raphaelchang/quadthingy-hardware/pcb/Quadrotor/Project Outputs for Quadrotor/Quadrotor.xls

Comment | Description | Designator | Footprint | LibRef | Quantity
4.7uF | CAP 4.7uF 6.3V ±10% 0402 (1005 Metric) Thickness 0.6mm SMD | C1, C6, C21, C22, C23, C24, C25, C26, C28, C29, C31, C32 | CAPC0402(1005)60_L | CMP-1034-02136-1 | 12.0
15pF | CAP 15pF 25V ±0.25pF 0402 (1005 Metric) Thickness 0.6mm SMD | C2, C3 | CAPC0402(1005)60_M | CMP-1034-00804-1 | 2.0
22pF | CAP 22pF 25V ±10% 0402 (1005 Metric) Thickness 0.6mm SMD | C4, C5 | CAPC0402(1005)60_L | CMP-1034-00911-1 | 2.0
100nF | CAP 100nF 6.3V ±5% 0402 (1005 Metric) Thickness 0.6mm SMD | C7, C10, C14 | CAPC0402(1005)60_M | CMP-1034-02060-1 | 3.0
120nF | CAP 100nF 6.3V ±5% 0402 (1005 Metric) Thickness 0.6mm SMD | C8 | CAPC0402(1005)60_M | CMP-1034-02060-1 | 1.0
6.8nF | CAP 6.8nF 6.3V ±5% 0402 (1005 Metric) Thickness 0.6mm SMD | C9 | CAPC0402(1005)60_L | CMP-1034-01836-1 | 1.0
33nF | CAP 33nF 6.3V ±10% 0402 (1005 Metric) Thickness 0.6mm SMD | C11 | CAPC0402(1005)60_M | CMP-1034-01977-1 | 1.0
10nF | CAP 10nF 6.3V ±5% 0402 (1005 Metric) Thickness 0.6mm SMD | C12 | CAPC0402(1005)60_M | CMP-1034-01867-1 | 1.0
1nF | CAP 1nF 6.3V ±5% 0402 (1005 Metric) Thickness 0.6mm SMD | C13 | CAPC0402(1005)60_M | CMP-1034-01609-1 | 1.0
1.5pF | CAP 1.5pF 25V ±0.5pF 0402 (1005 Metric) Thickness 0.6mm SMD | C15 | CAPC0402(1005)60_L | CMP-1034-00110-1 | 1.0
1pF | CAP 1pF 25V ±0.5pF 0402 (1005 Metric) Thickness 0.6mm SMD | C16 | CAPC0402(1005)60_M | CMP-1034-00055-1 | 1.0
2.2nF | CAP 2.2nF 6.3V ±5% 0402 (1005 Metric) Thickness 0.6mm SMD | C17 | CAPC0402(1005)60_N | CMP-1034-01722-1 | 1.0
4.7pF | CAP 4.7pF 25V ±0.1pF 0402 (1005 Metric) Thickness 0.6mm SMD | C18 | CAPC0402(1005)60_M | CMP-1034-00362-1 | 1.0
15pF | CAP 15pF 25V ±10% 0402 (1005 Metric) Thickness 0.6mm SMD | C19, C20 | CAPC0402(1005)60_N | CMP-1034-00809-1 | 2.0
2.2uF | CAP 2.2uF 6.3V ±10% 0402 (1005 Metric) Thickness 0.6mm SMD | C27 | CAPC0402(1005)60_M | CMP-1034-02125-1 | 1.0
10uF | CAP 10uF 6.3V ±20% 0402 (1005 Metric) Thickness 0.6mm SMD | C30 | CAPC0402(1005)60_N | CMP-1034-02138-1 | 1.0
0.1uF | CAP 100nF 6.3V ±5% 0402 (1005 Metric) Thickness 0.6mm SMD | C33 | CAPC0402(1005)60_M | CMP-1034-02060-1 | 1.0
LED-BLUE |  | D1 | LED-1206 | LED-BLUE1206 | 1.0
WS2812B |  | D2, D4, D5, D6 | WS2812B | WS2812B | 4.0
LED-GREEN |  | D3 | LED-1206 | LED-GREEN1206 | 1.0
MBRA210LT3G | Schottky Power Rectifier, 2-Pin SMA, Pb-Free, Tape and Reel | D7 | ONSC-SMA-2-403D-02_F_V | CMP-1055-00309-1 | 1.0
 |  | JP1, JP2 | JST-2-PTH-VERT | JST_2_RIGHT | 2.0
USB |  | JP3 | USB-MICROB | USB_MICROB_PLUG-SMT | 1.0
3.9nH | Inductor | L1 | INDC0402(1005)_N | INDC0402 | 1.0
8.2nH | Inductor | L2 | INDC0402(1005)_N | INDC0402 | 1.0
2.7nH | Inductor | L3 | INDC0402(1005)_N | INDC0402 | 1.0
MOSFET-P | P-Channel MOSFET | Q1 | SOT23-3 | MOSFET-P | 1.0
22R | 22R 0.063W 5% 0402 (1005 Metric) SMD | R1, R2 | RESC0402(1005)_M | CMP-1011-00034-1 | 2.0
10K | 10K 0.063W 5% 0402 (1005 Metric) SMD | R3, R4, R5, R6, R7, R8, R9, R10, R11, R19 | RESC0402(1005)_N | CMP-1011-00098-1 | 10.0
22K | 22K 0.063W 5% 0402 (1005 Metric) SMD | R12 | RESC0402(1005)_L | CMP-1011-00106-1 | 1.0
10R | 10R 0.063W 5% 0402 (1005 Metric) SMD | R13 | RESC0402(1005)_N | CMP-1011-00026-1 | 1.0
0.006R | Jumper 0805 (2012 Metric) | R14 | RESC0805(2012)_N | CMP-1013-00001-1 | 1.0
91R | 91R 0.063W 5% 0402 (1005 Metric) SMD | R15 | RESC0402(1005)_M | CMP-1011-00049-1 | 1.0
0.1R | 1R 0.1W 5% 0603 (1608 Metric) SMD | R16 | RESC0603(1608)_M | CMP-1012-00002-1 | 1.0
19K6 | 20K 0.063W 5% 0402 (1005 Metric) SMD | R17 | RESC0402(1005)_M | CMP-1011-00105-1 | 1.0
5K1 | 5K1 0.063W 5% 0402 (1005 Metric) SMD | R18 | RESC0402(1005)_L | CMP-1011-00091-1 | 1.0
 | Switch, SPNO Push Button SMD | SW1, SW2 | SWITCH | DIPT-DTSM-6 | 2.0
STMF446 |  | U1 | STM-LQFP64_N | MC-ARM-STM32F4X5-SQ64 | 1.0
MS5611 |  | U2 | MS5611 | MS5611 | 1.0
BNO055 |  | U3 | LGA28R50P4X10_380X520X100 | BNO055 | 1.0
 |  | U4 | QFN20 | NRF24L01+ | 1.0
ADM7171 |  | U5 | SON50P300X85_HS-9N | ADM7171 | 1.0
MCP8063 | 3-Phase Brushless DC Sinusoidal Sensorless Fan Motor Driver, MOSFET Output, 2 to 14 V, 8-pin SOP (SE8), Tube | U6, U7, U9, U11 | DFN8 | MCP8063 | 4.0
MAX4173 | Voltage-Output, High-Side Current-Sense Amplifier, 50 V / V Gain, -40 to 85 degC, 6-Pin SOT23 (U6+1), Pb-Free, Tape and Reel | U8 | MAXM-U6+1_M | CMP-0252-00331-1 | 1.0
LTC1731 | Linear Charger with AC Adapter Detection, 4.5 to 12 V Vin, 8-pin SOP (MS8-8), -40 to 85 degC, Pb-Free, Tape and Reel | U10 | LT-MS8-8_L | CMP-0471-00369-1 | 1.0
 |  | Y1, Y2 | ABRA-ABM3B-4_V | ABRA-ABM3B-4 | 2.0
ABS07 |  | Y3 | ABS07 | ABS07 | 1.0
