raphaelchang/quadthingy-hardware/cad/MotorMount_Alt.SLDPRT

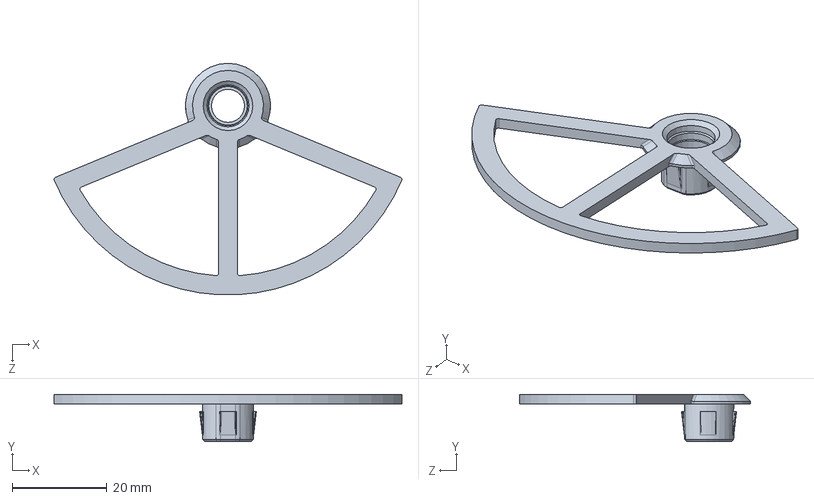
[picture p1: CAD file, 2020-12-25]
cad/MotorMount_Alt.SLDPRT
73.6 x 10.0 x 48.9 mm
