raphaelchang/quadthingy-hardware/pcb/outline.dxf

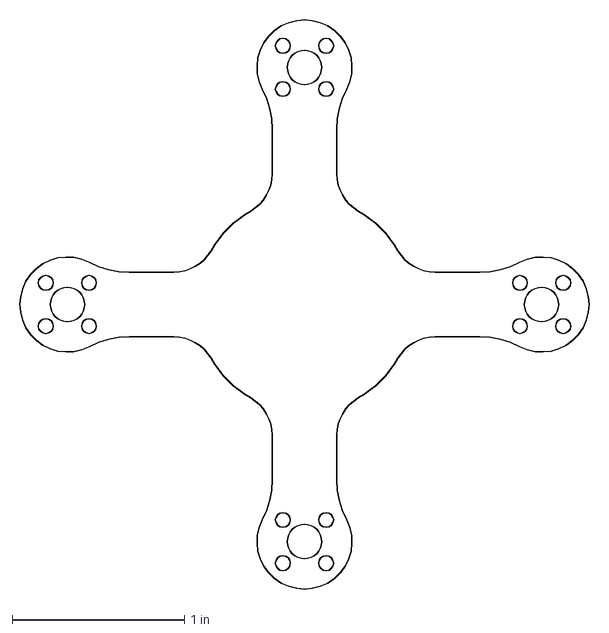
[picture p2: CAD file, 2016-02-01]
pcb/outline.dxf
3.34 x 3.34 in
