raphaelchang/quadthingy-hardware/pcb/Quadrotor/Outline.SLDPRT

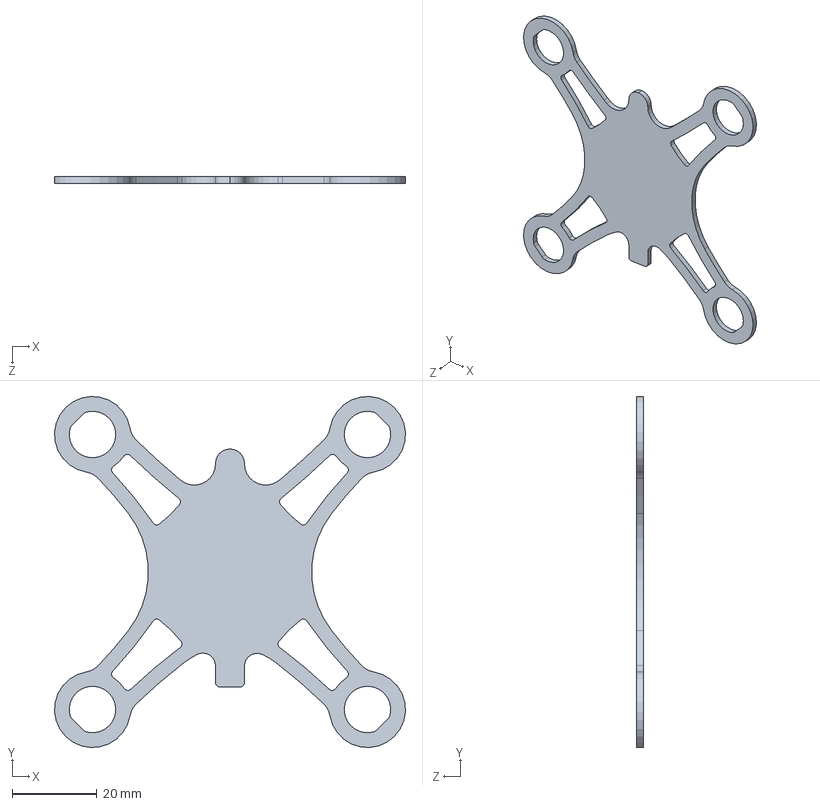
[picture p3: CAD file, 2016-12-26]
pcb/Quadrotor/Outline.SLDPRT
83.0 x 83.0 x 1.60 mm
