raphaelchang/quadthingy-hardware/cad/MotorMount.STEP

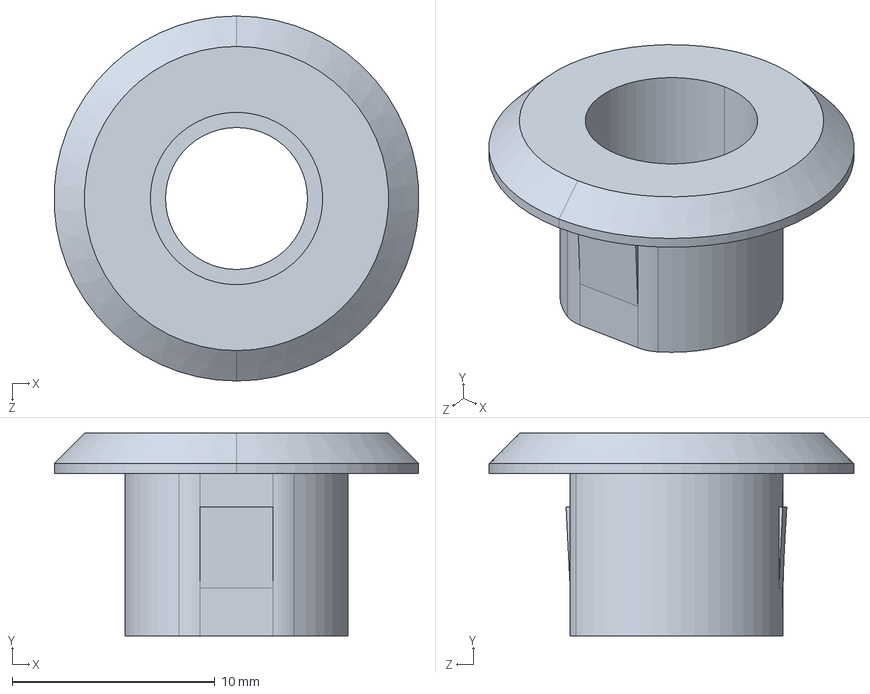
[picture p4: CAD file, 2020-12-25]
cad/MotorMount.STEP
18.0 x 10.0 x 18.0 mm
