raphaelchang/quadthingy-hardware/cad/BaseStationTop.SLDPRT

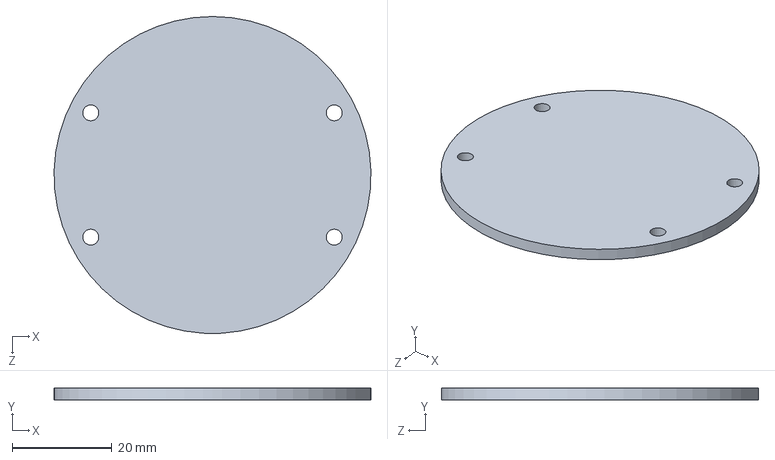
[picture p5: CAD file, 2020-12-25]
cad/BaseStationTop.SLDPRT
63.5 x 2.38 x 63.5 mm
