raphaelchang/quadthingy-hardware/cad/Motor.STEP

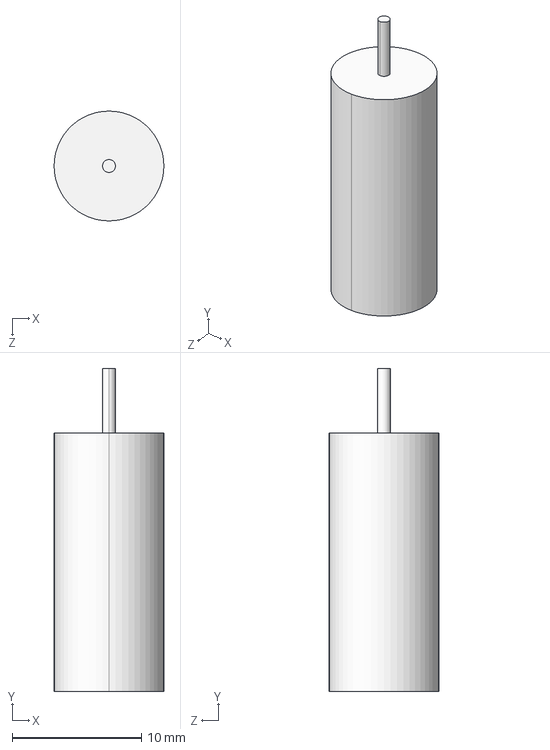
[picture p6: CAD file, 2016-12-26]
cad/Motor.STEP
8.50 x 25.0 x 8.50 mm
