raphaelchang/quadthingy-hardware/cad/MotorHolder.SLDPRT

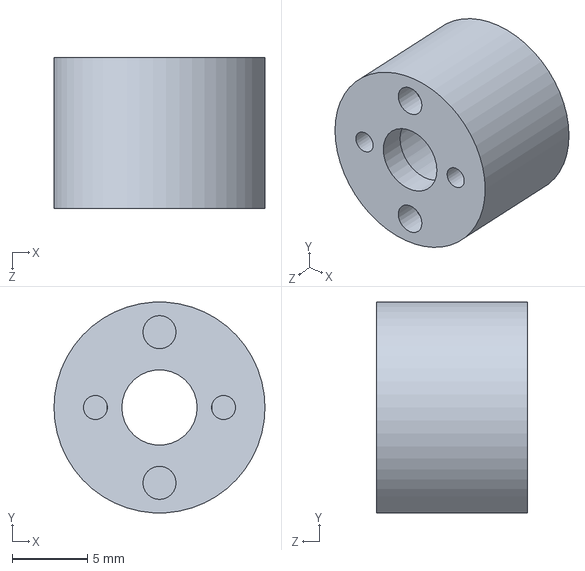
[picture p7: CAD file, 2016-05-14]
cad/MotorHolder.SLDPRT
14.0 x 14.0 x 10.0 mm
