raphaelchang/quadthingy-hardware/(list of files, cad)

Other CAD files:
cad/Motor.SLDPRT
pcb/OldVersions/V1.1/outline.ipt
pcb/OldVersions/V1/OldVersions/outline.0006.ipt
pcb/OldVersions/V1/OldVersions/outline.0008.ipt
pcb/OldVersions/V1/outline.ipt
pcb/Quadrotor/Outline.DXF
pcb/outline.ipt
