raphaelchang/quadthingy-hardware/pcb/Quadrotor/Quadrotor.pdf

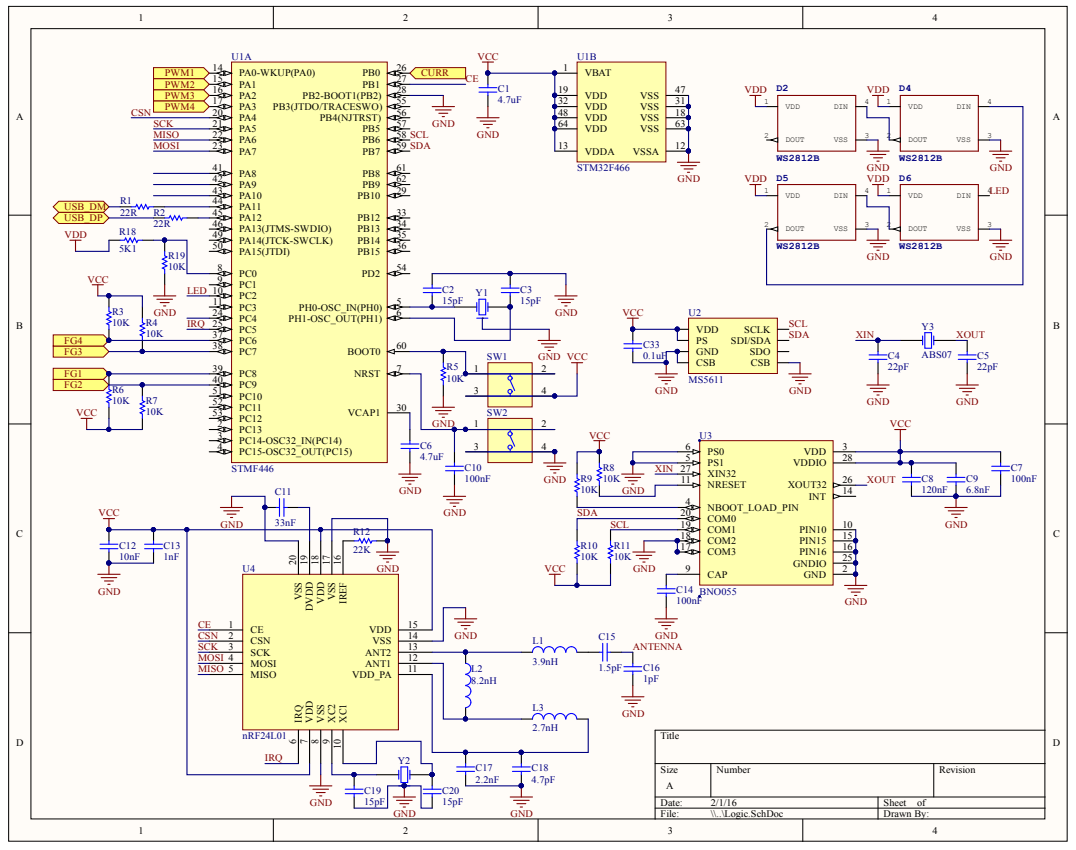
[picture p8: page 1]

CE 1 CSN 2 SCK 3 MOSI 4 MISO 5

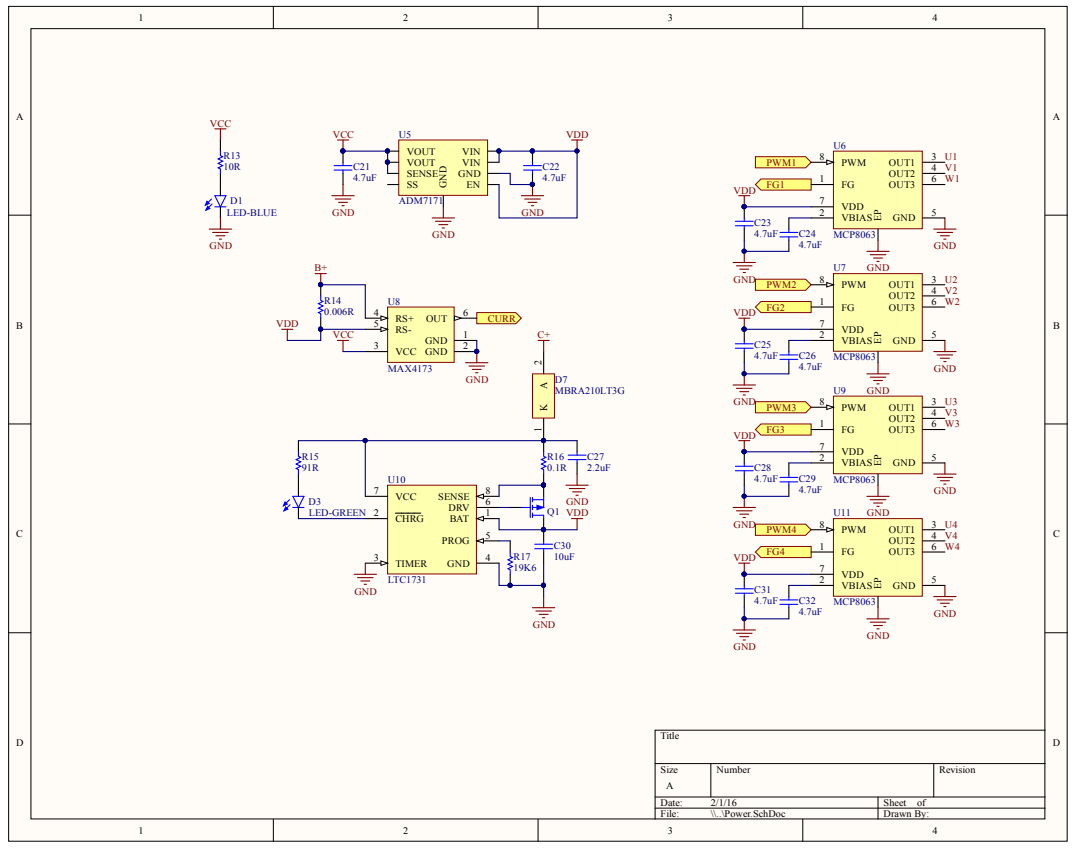
[picture p9: page 2]

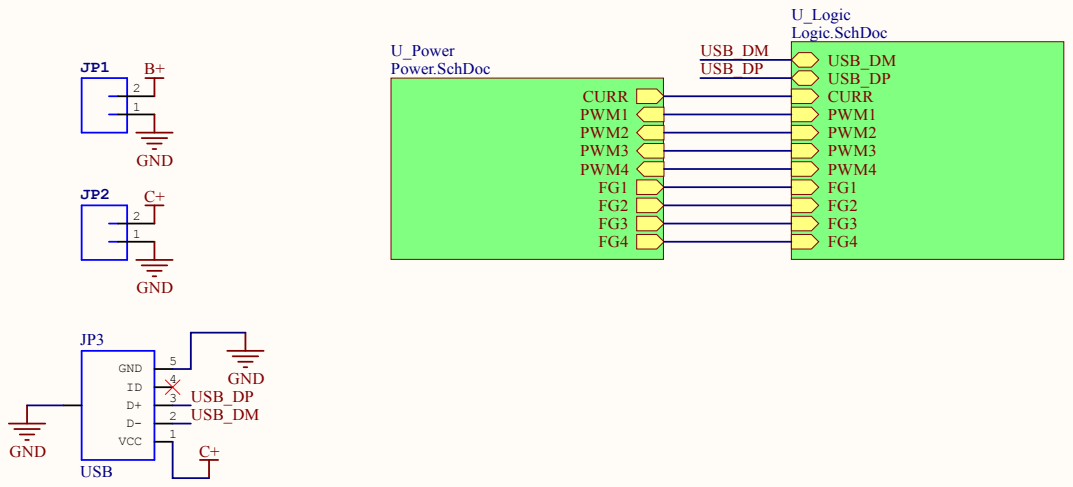
[picture p10: page 3]

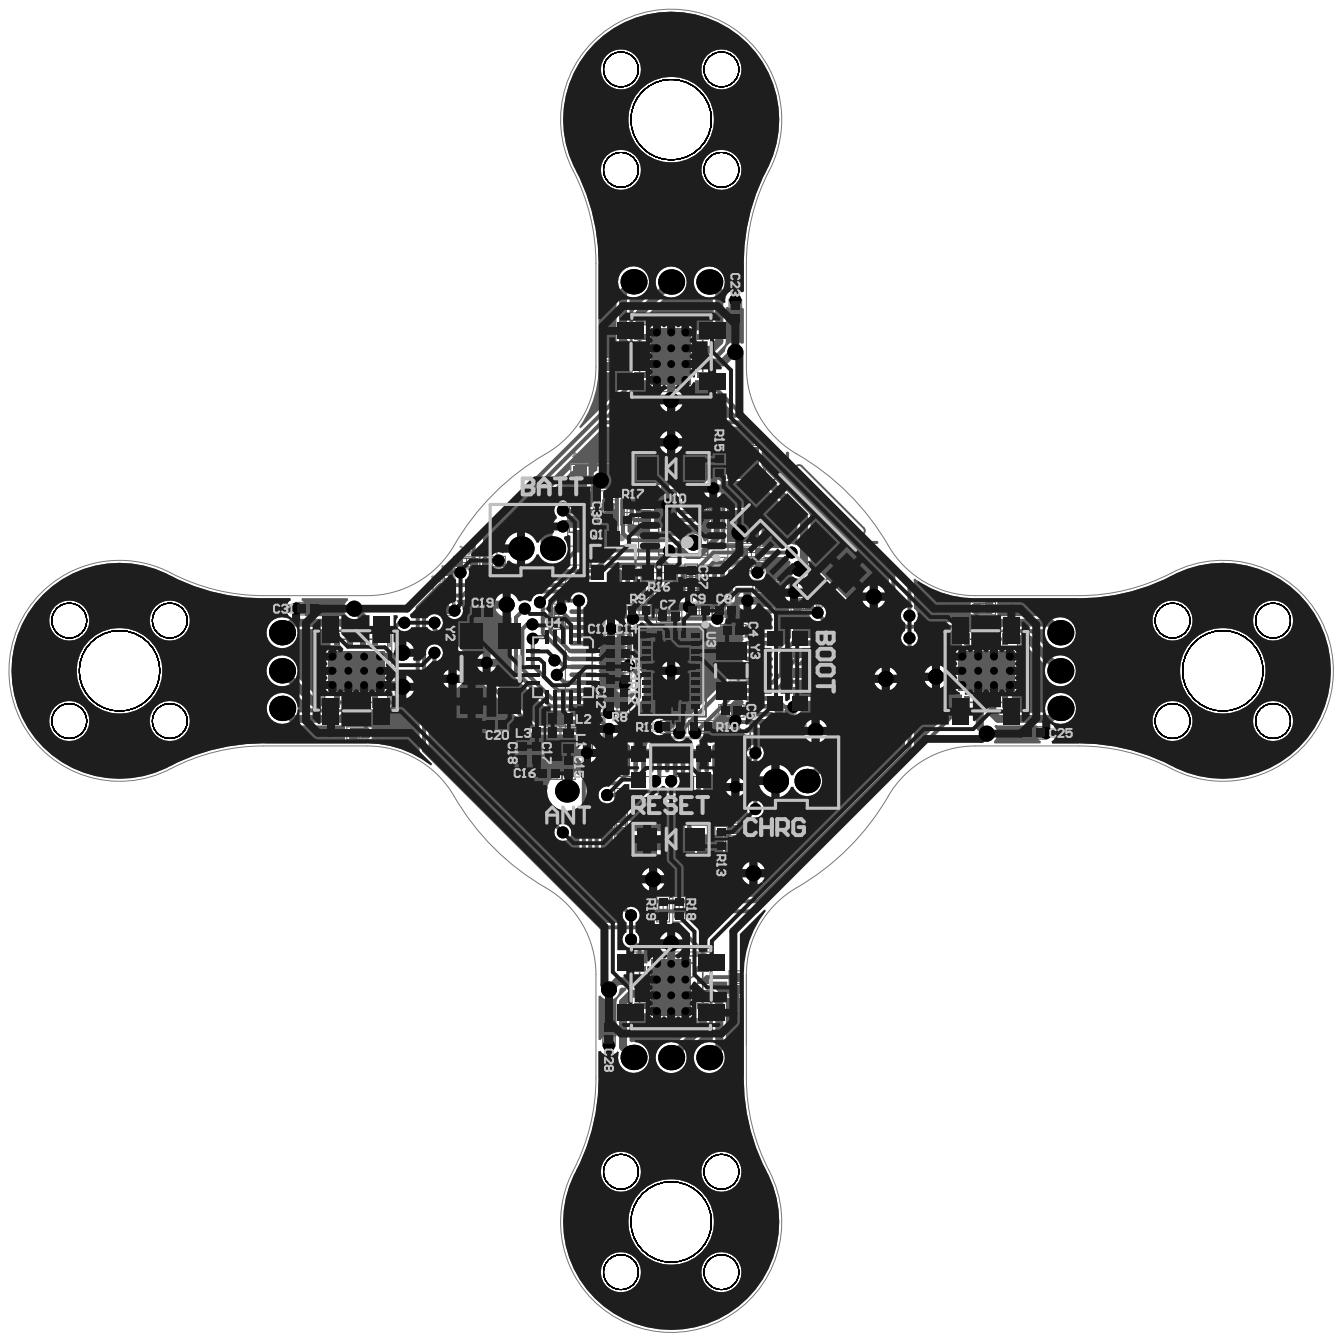
[picture p11: page 4]
