raphaelchang/quadthingy-hardware/pcb/BaseStation/Project Outputs for BaseStation/PDF/BaseStation.PDF

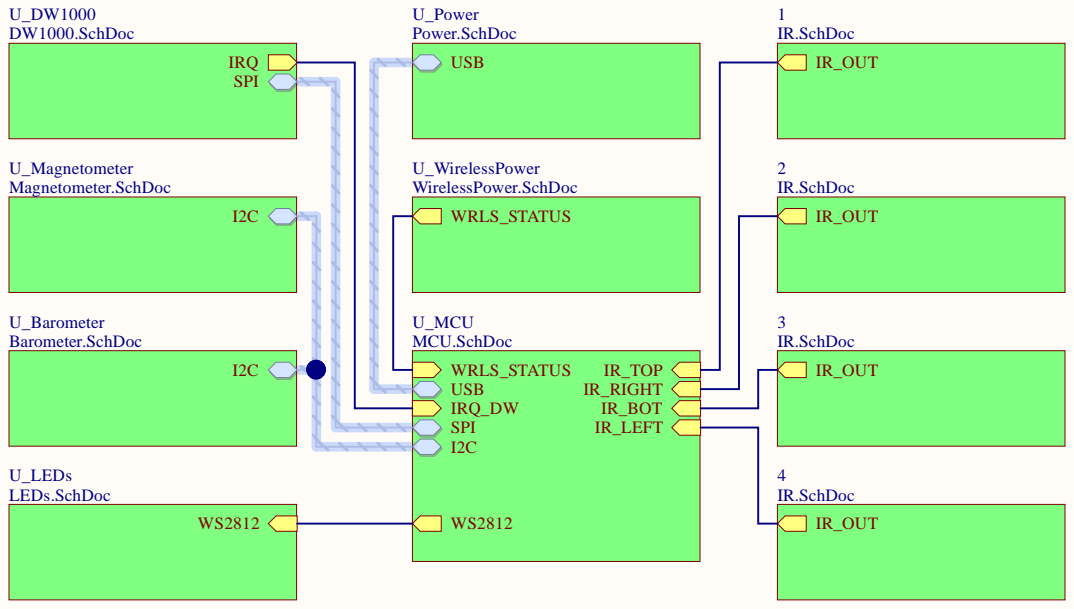
[picture p12: page 1]

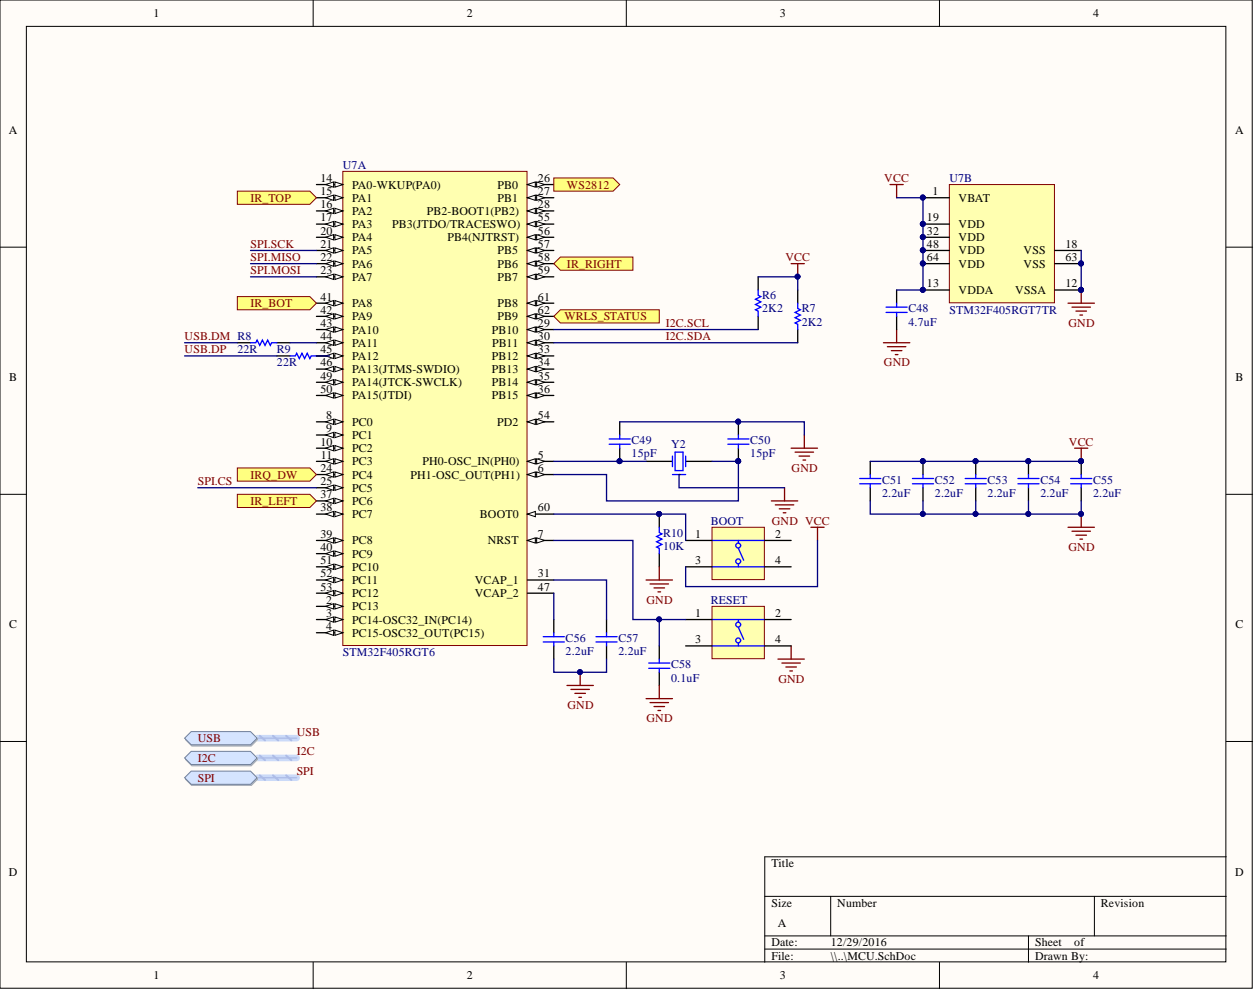
[picture p13: page 2]

PC8 39 | R10
PC9 40 | 10K | 3 | 4

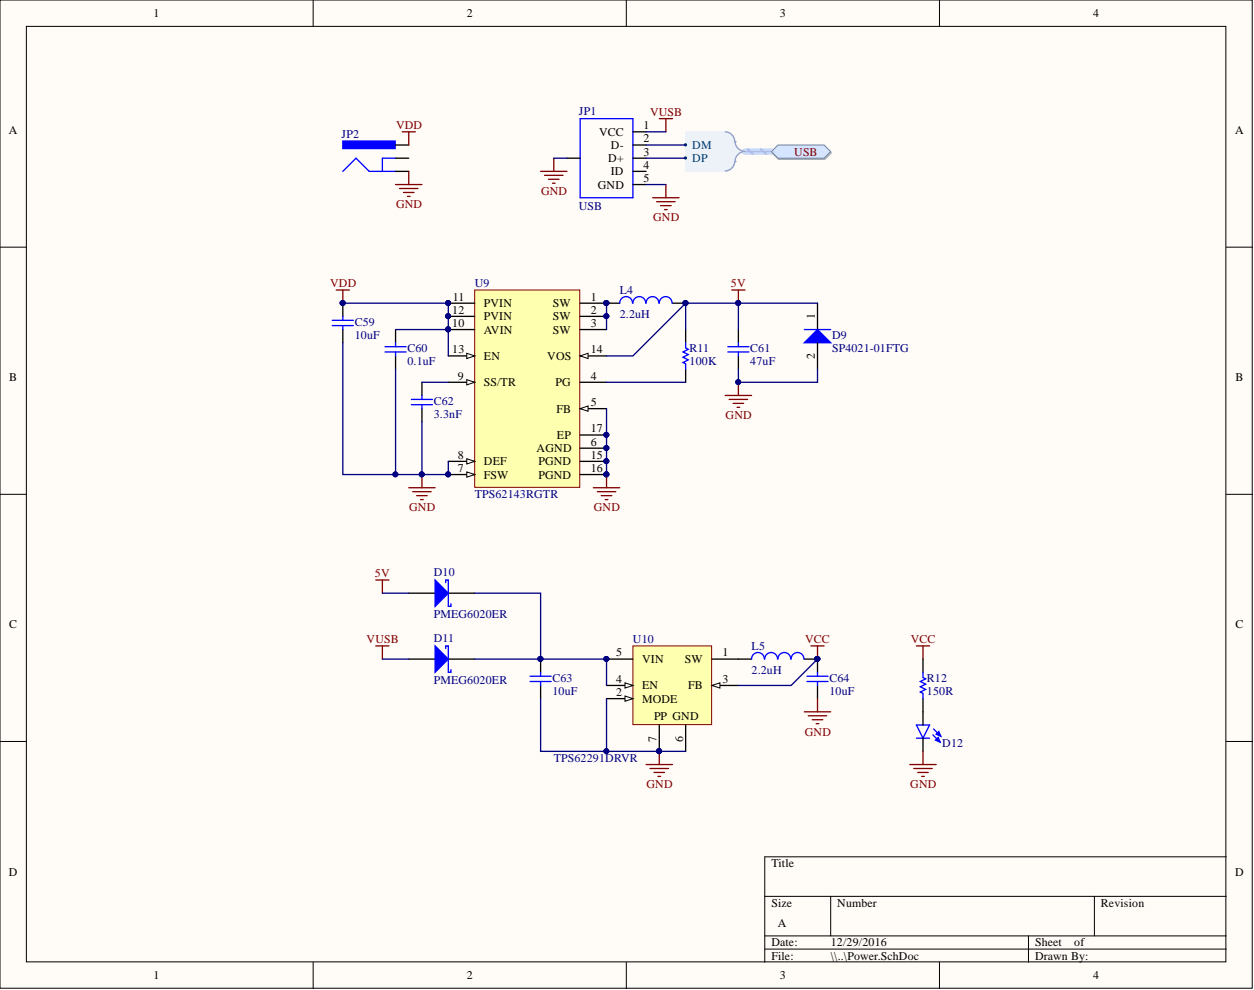
[picture p14: page 3]

C60
0.1uF | SS/TR 9

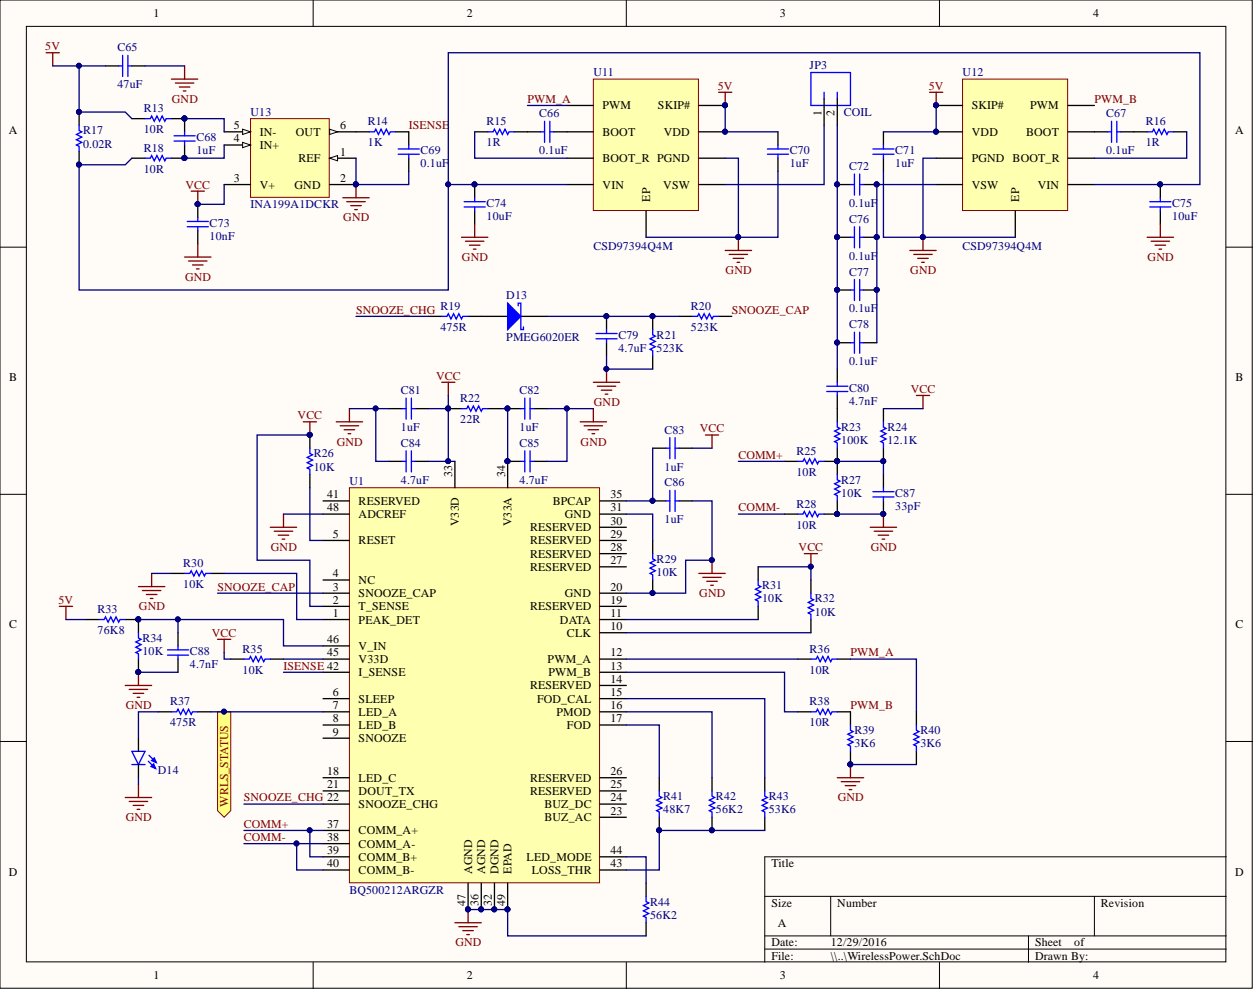
[picture p15: page 4]

R34 | VCC | V33D 45 V_IN 46

I_SENSE 42

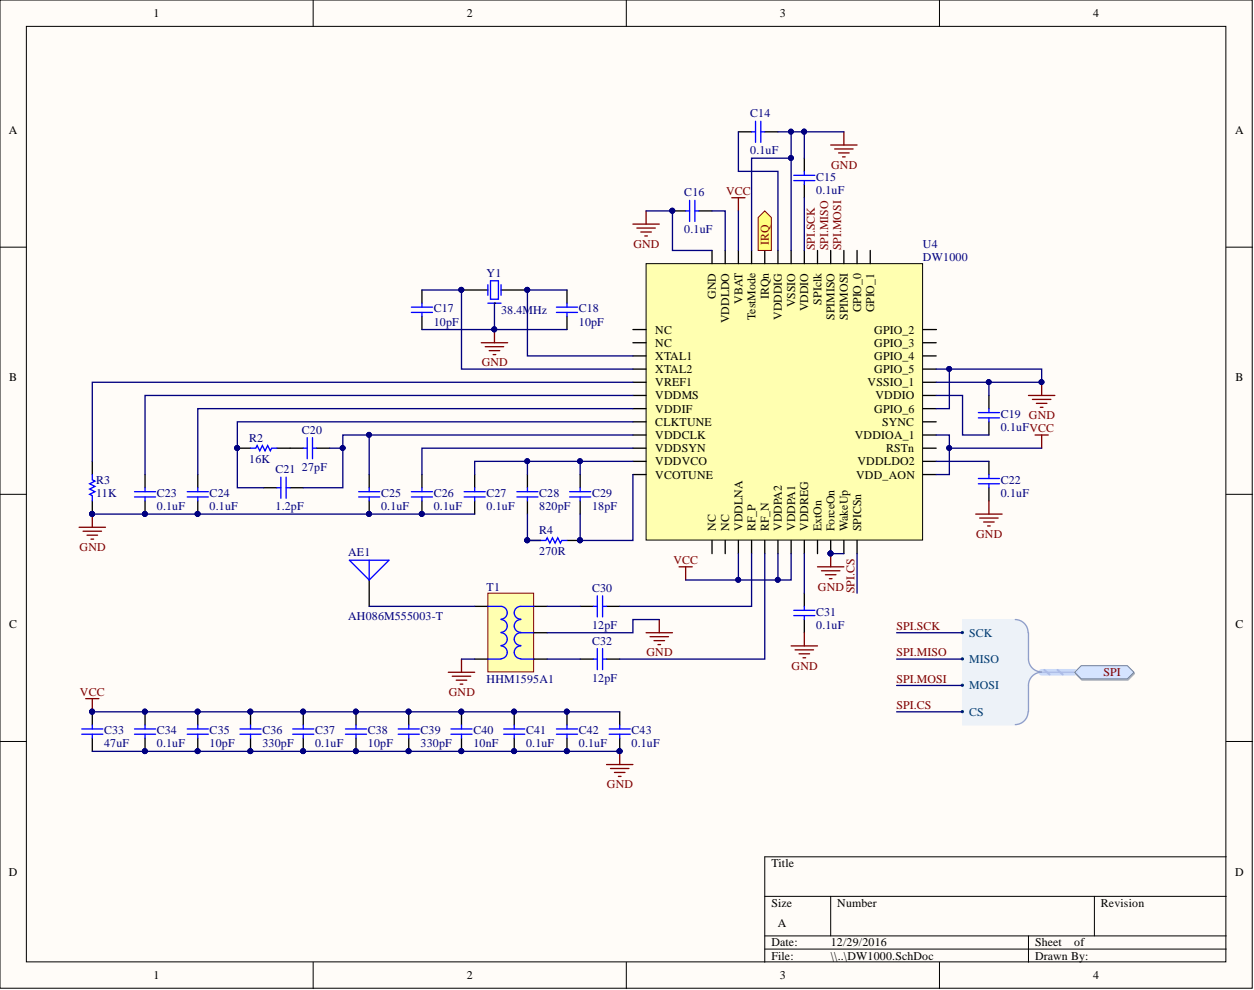
[picture p16: page 5]

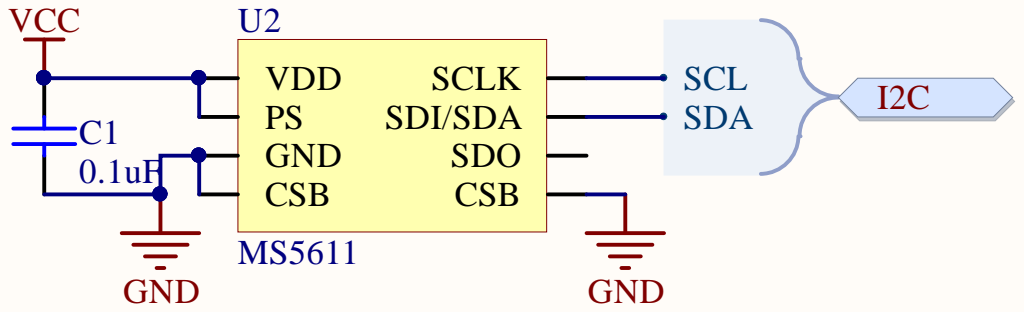
[picture p17: page 6]

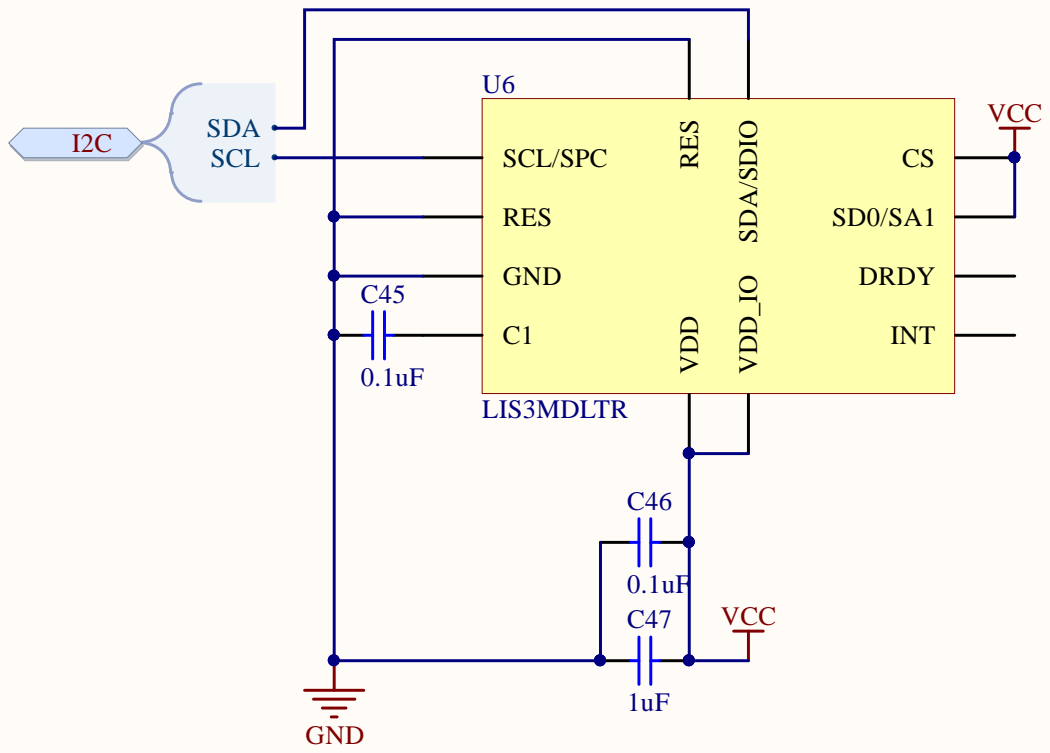
[picture p18: page 7]

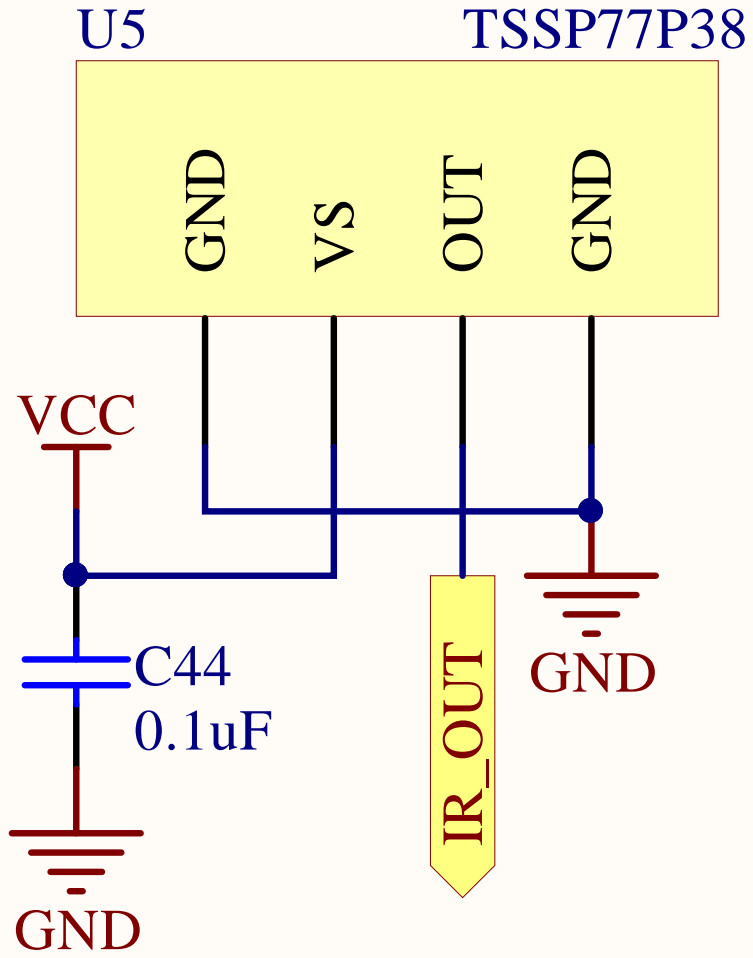
[picture p19: page 8]

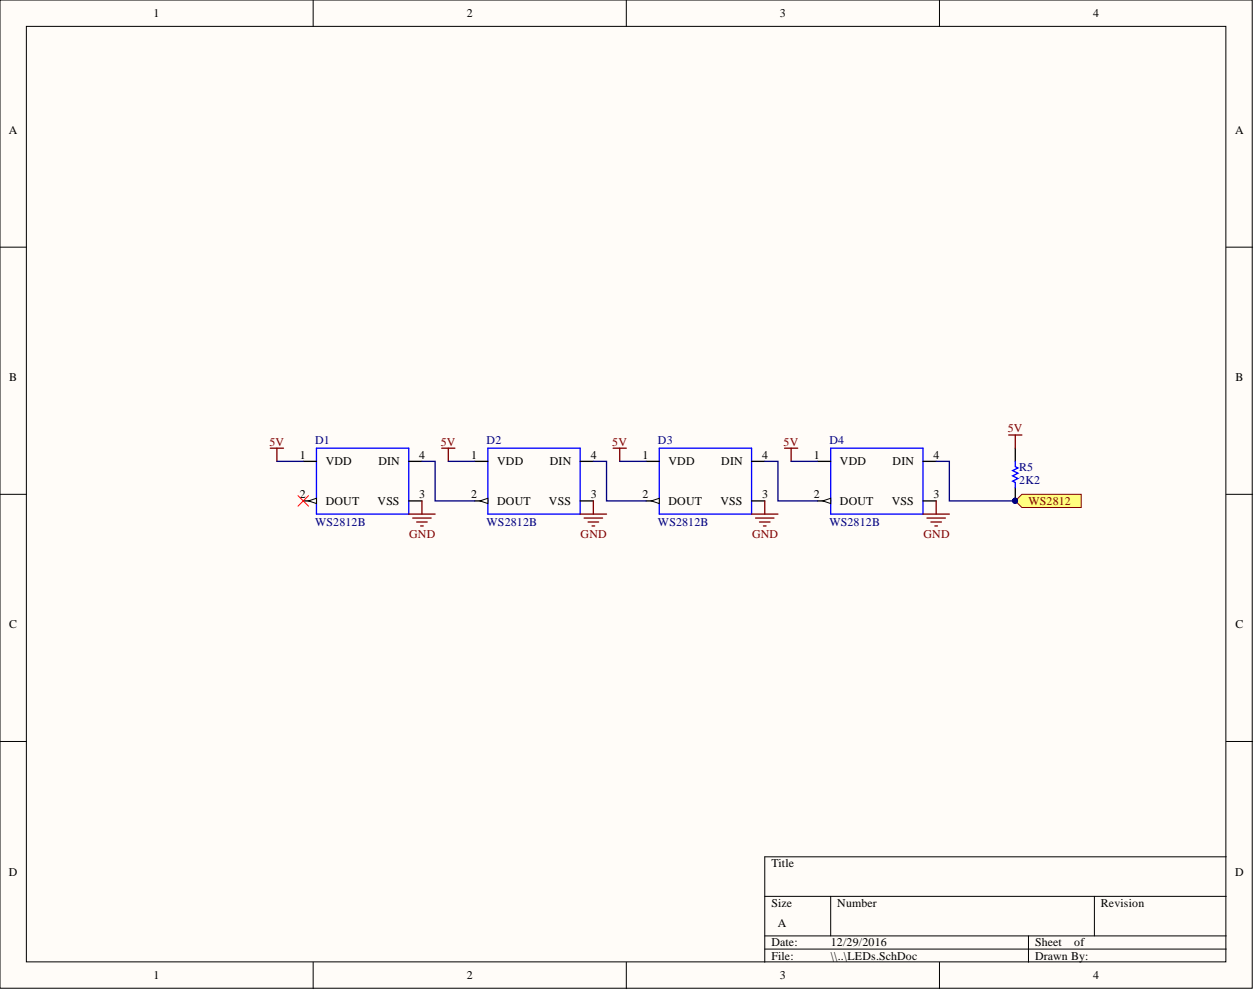
[picture p20: page 9]

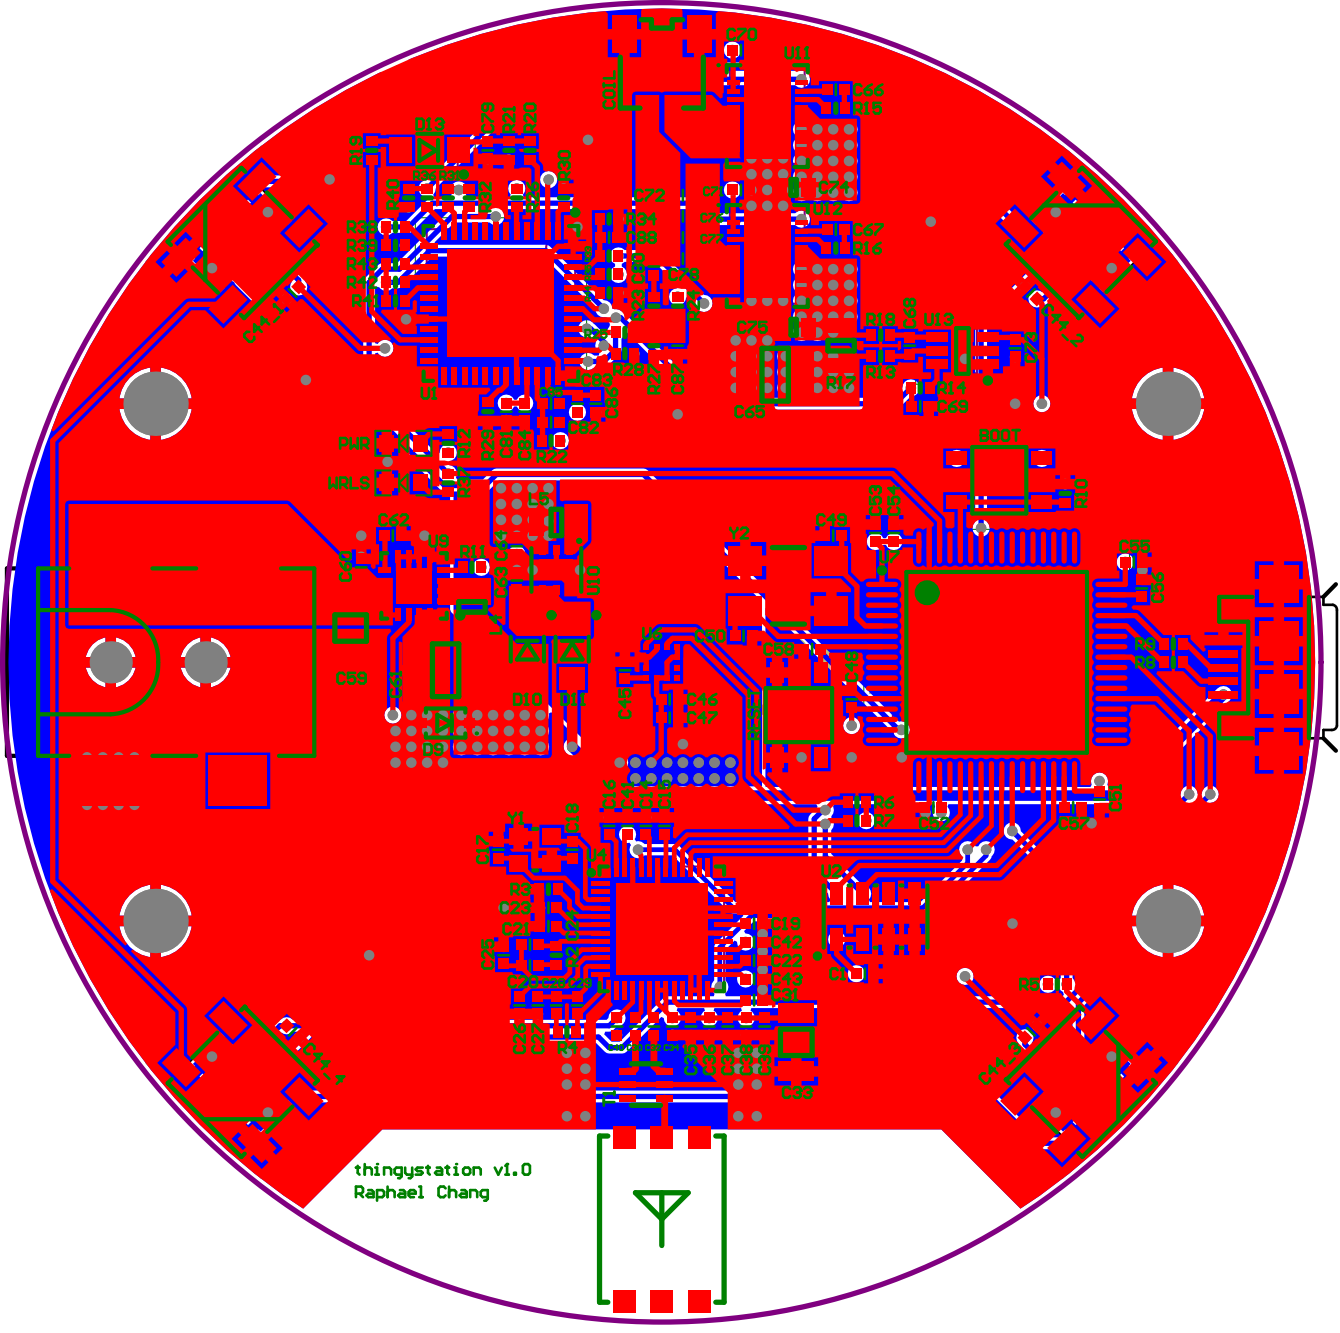
[picture p21: page 10]

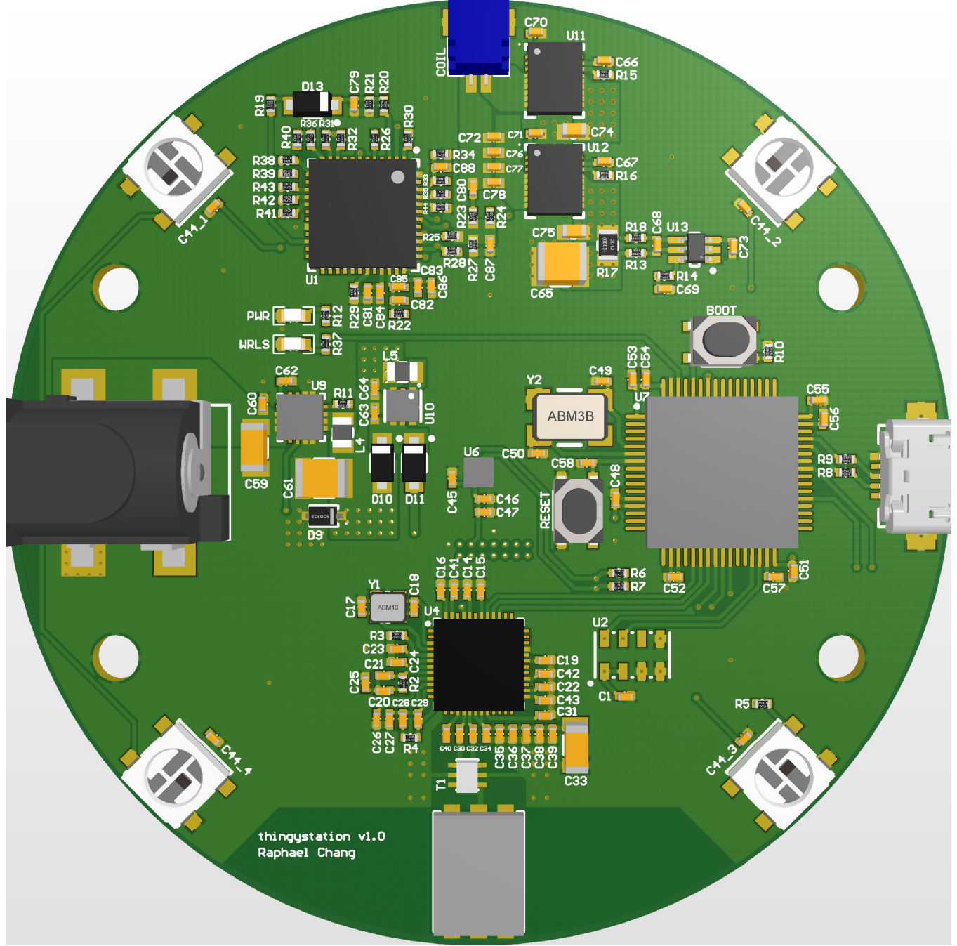
[picture p22: page 11]

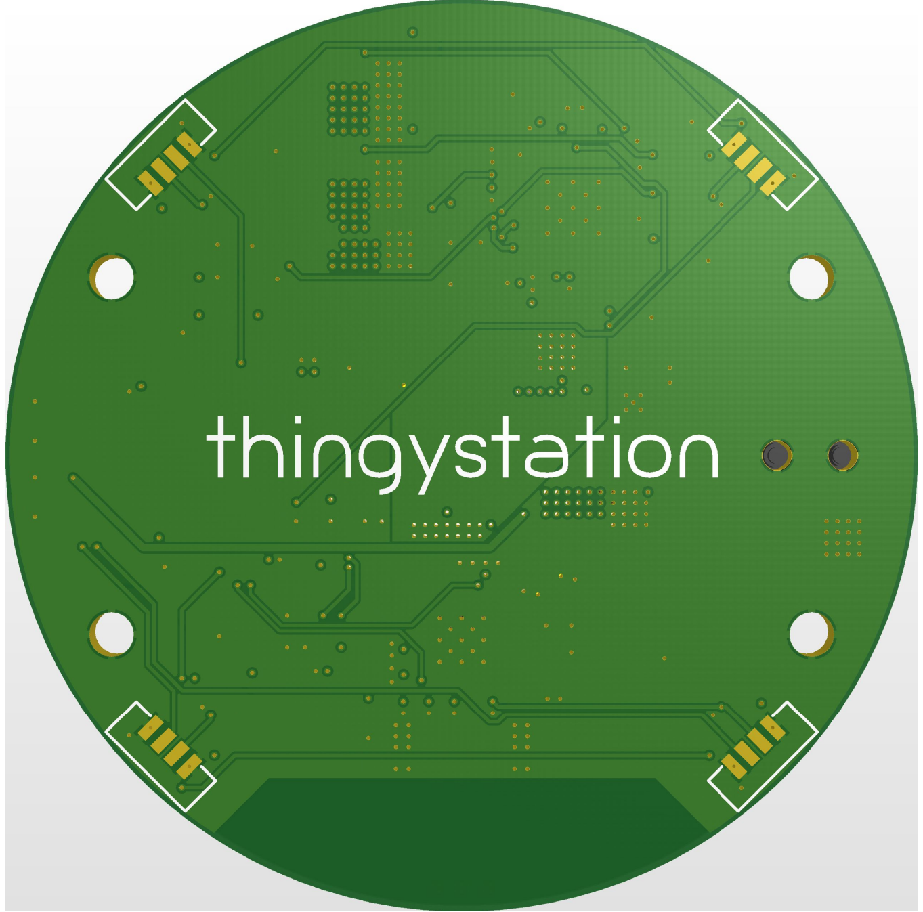
[picture p23: page 12]
