raphaelchang/quadthingy-hardware/pcb/Quadrotor/Project Outputs for Quadrotor/PDF/Quadrotor.PDF

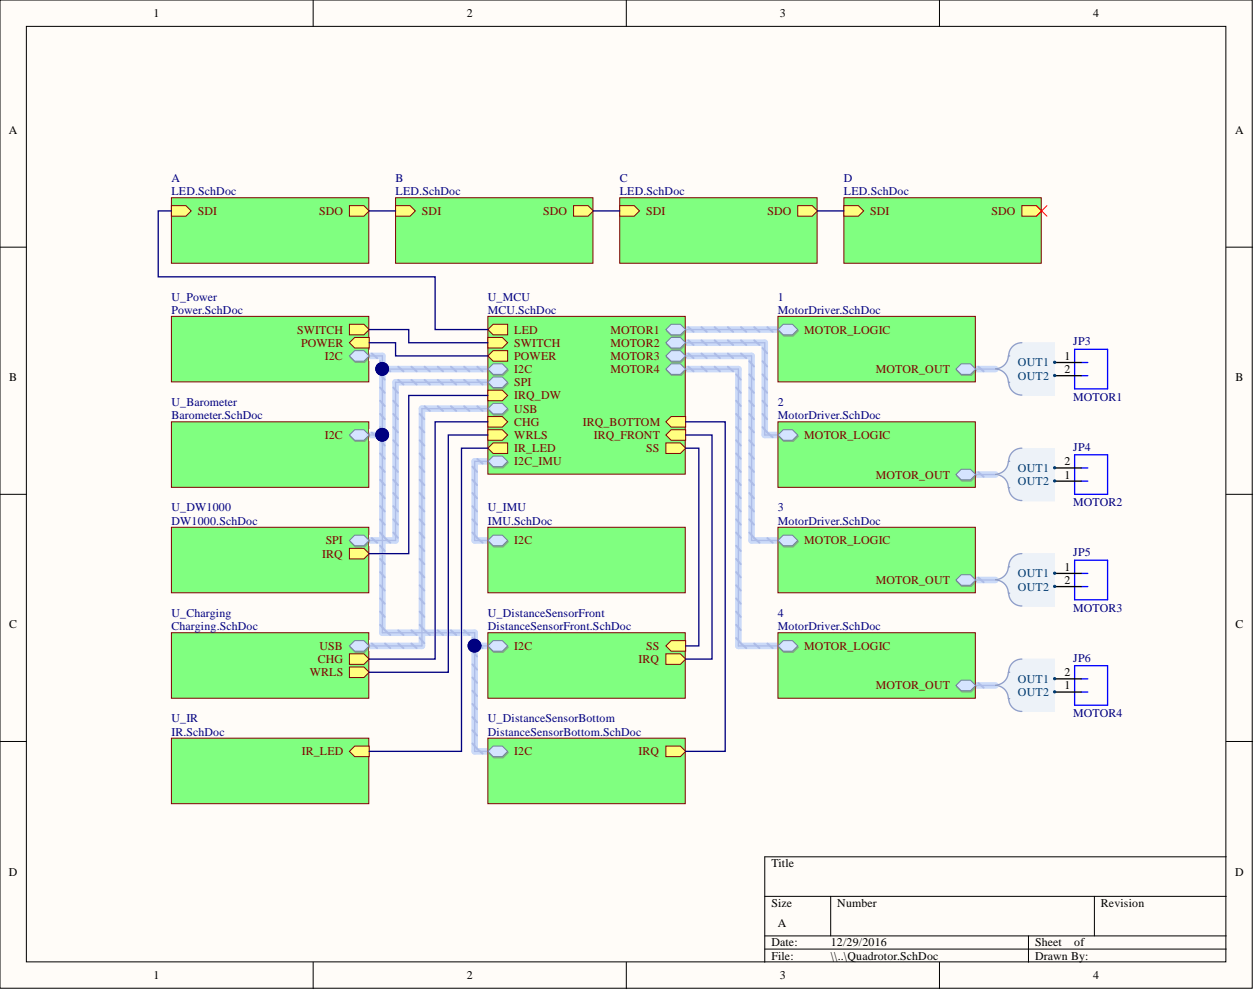
[picture p24: page 1]

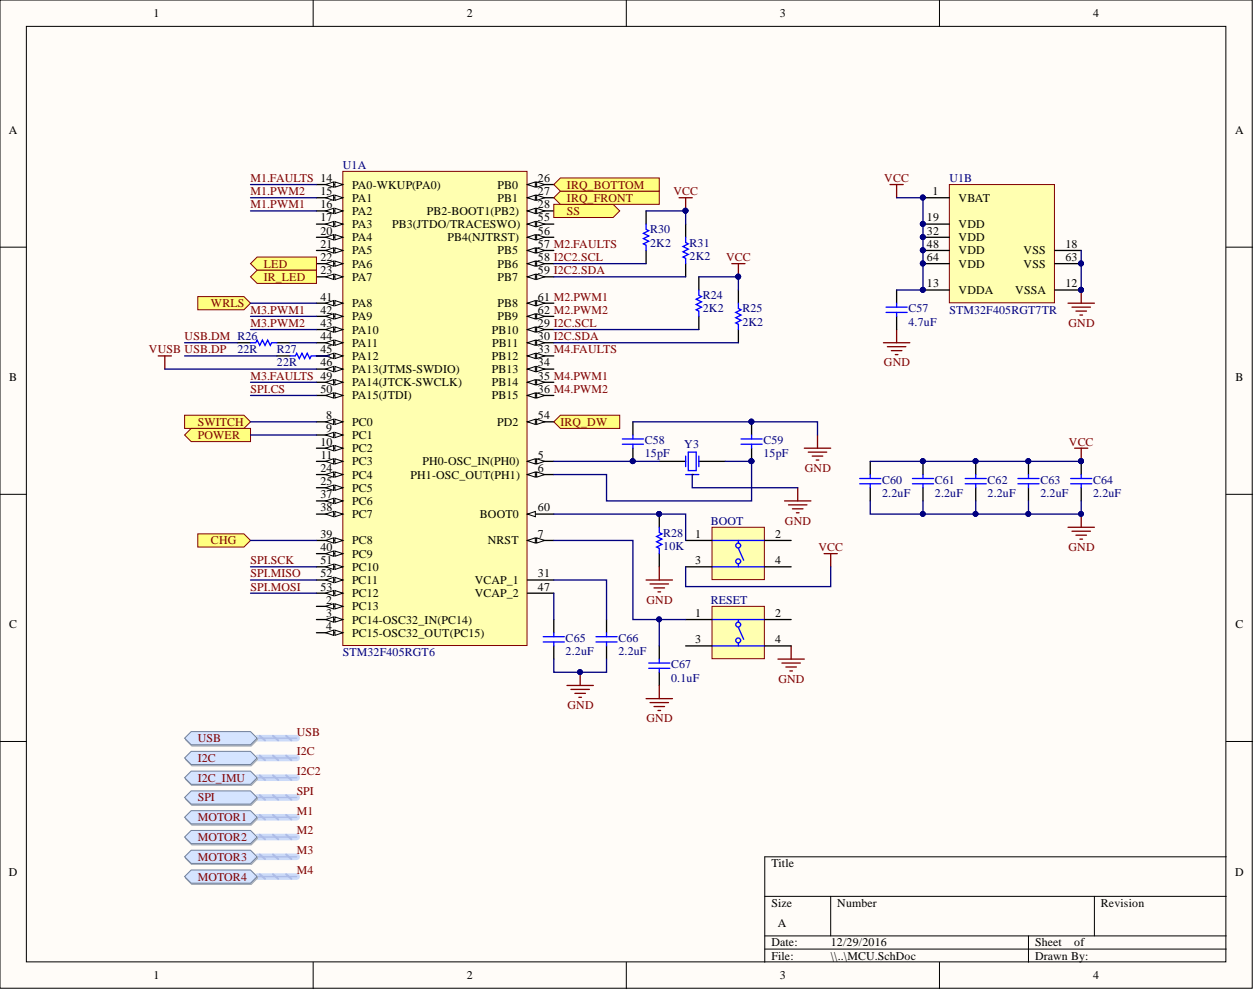
[picture p25: page 2]

7 | R2 8
3 1 | 1 0 K | 3

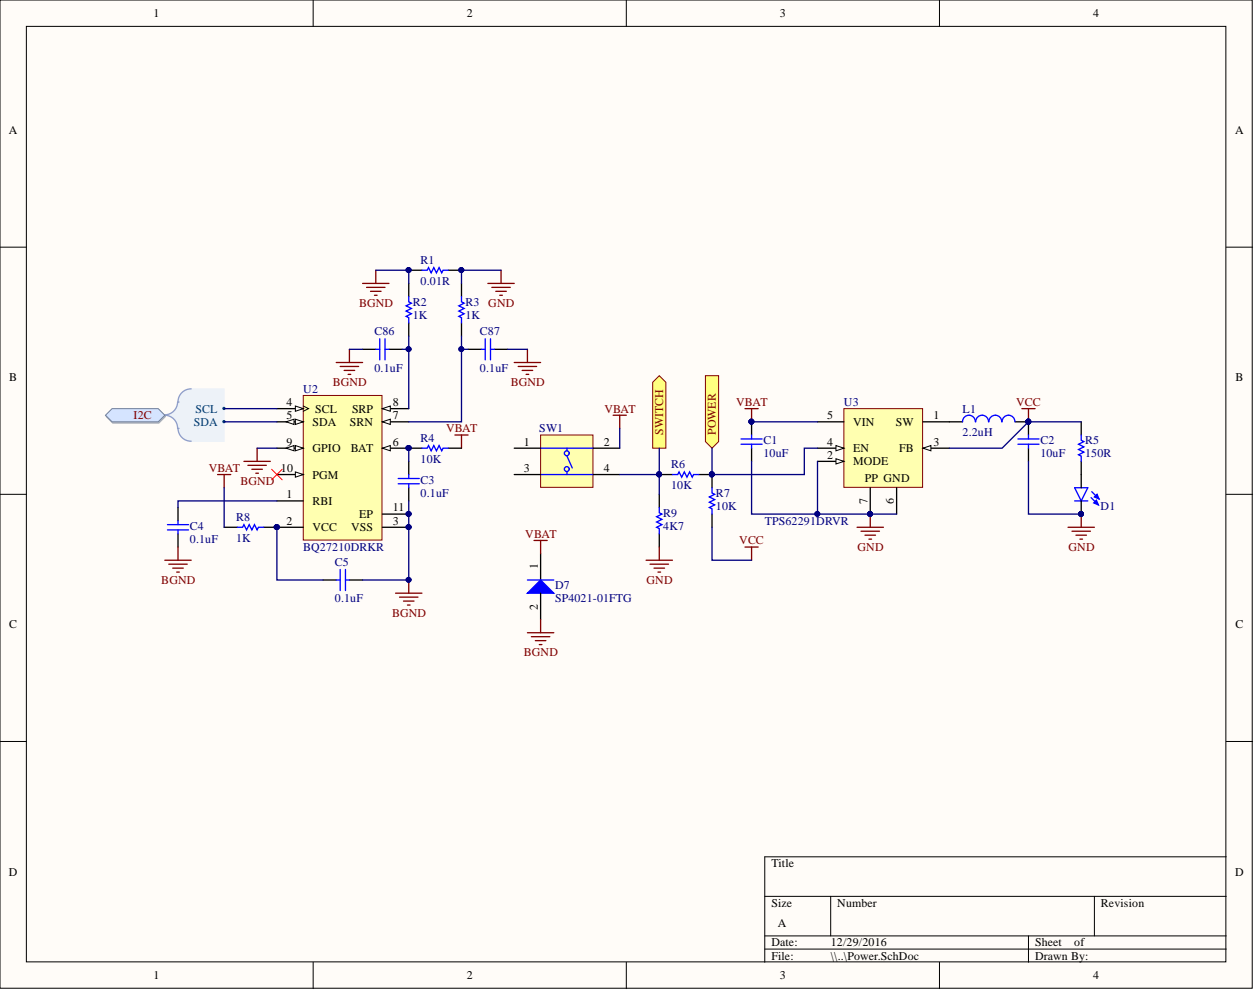
[picture p26: page 3]

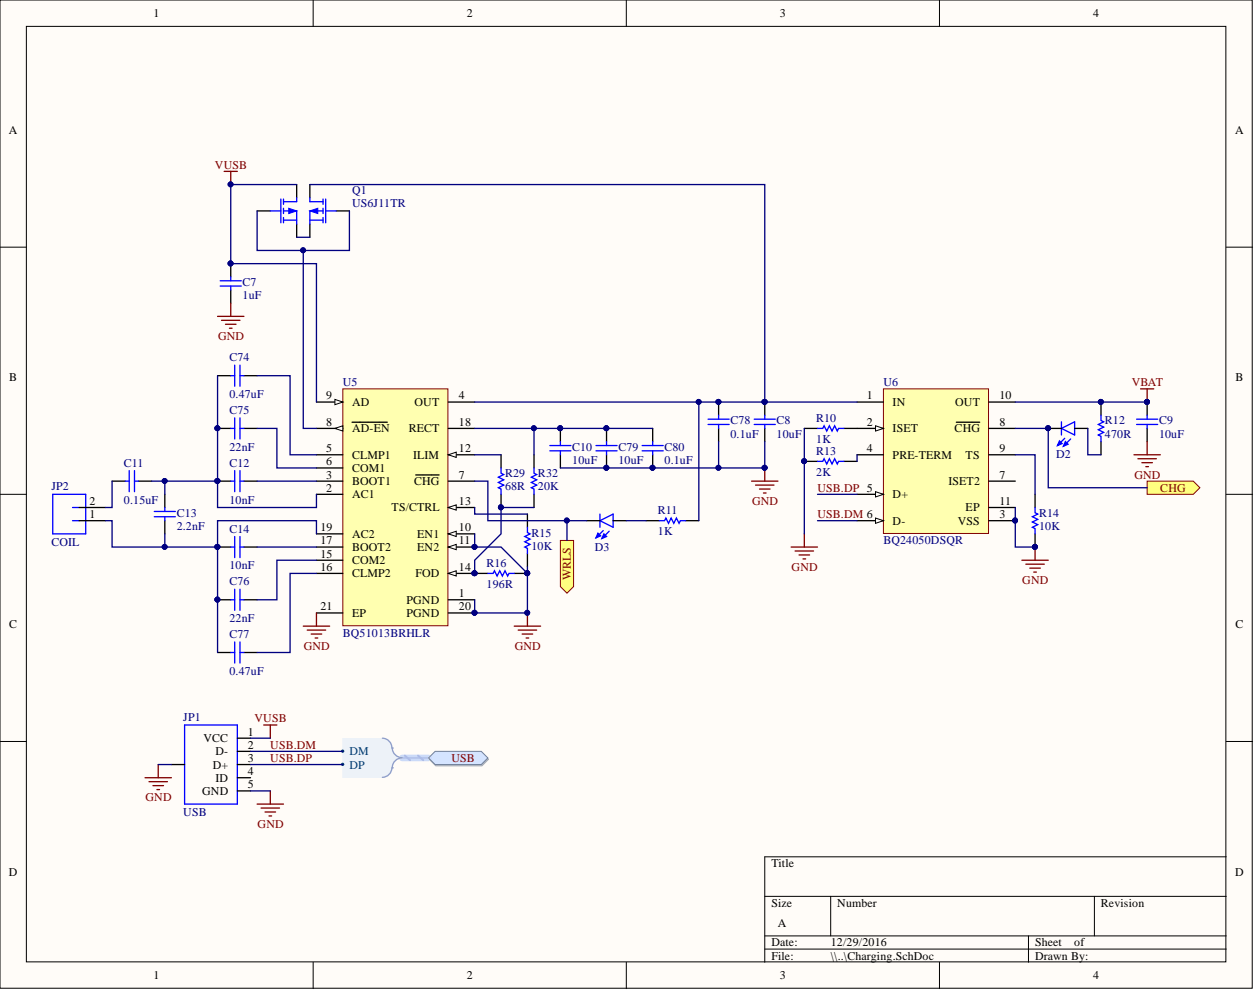
[picture p27: page 4]

AD-EN 8 RECT CHG FOD PGND | 18 14 COM2 15 20 EP 21 | C78 | ISET 2 PRE-TERM 4 D+ 5 D- 6

COM1 6 | 7

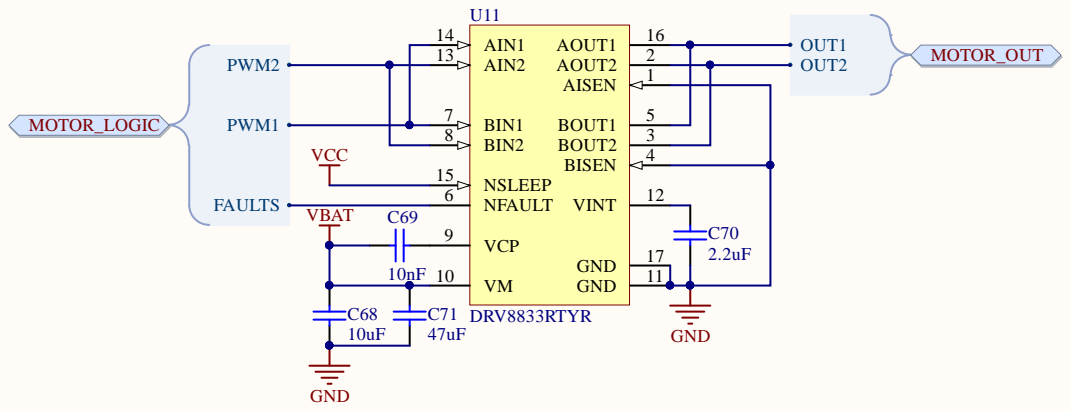
[picture p28: page 5]

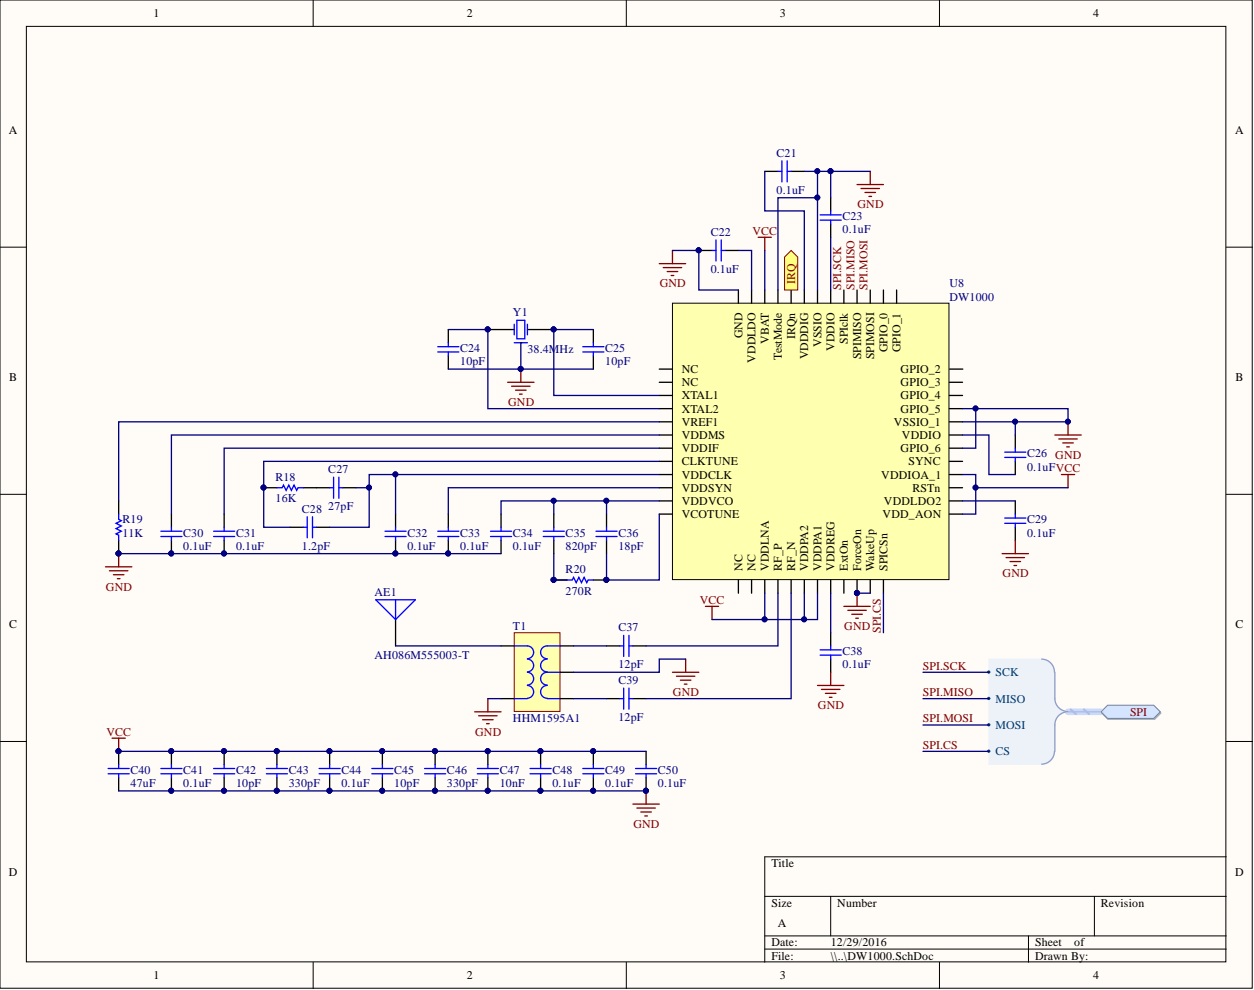
[picture p29: page 6]

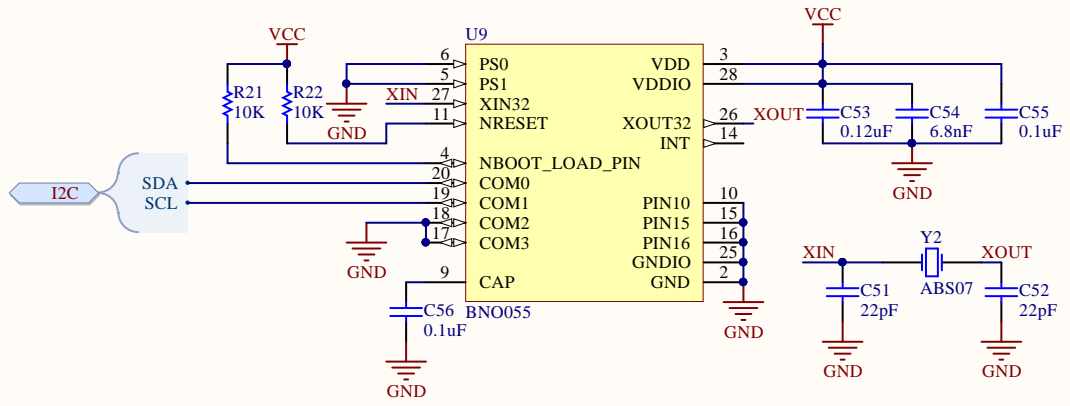
[picture p30: page 7]

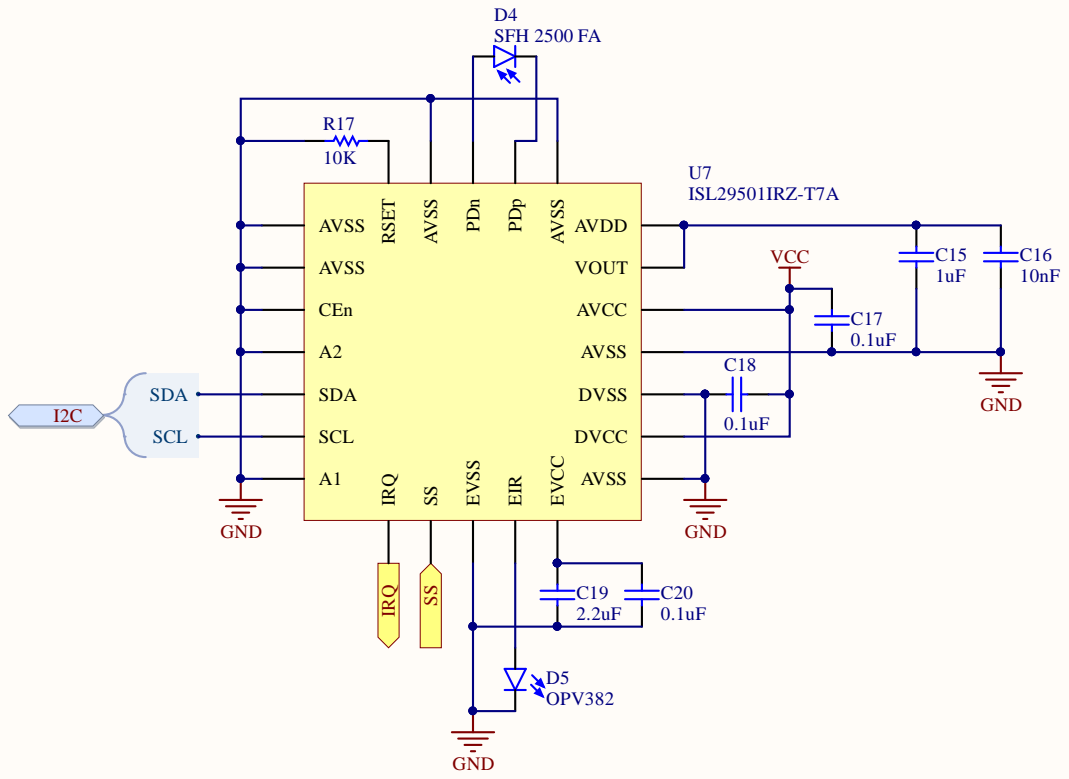
[picture p31: page 8]

VCC C15

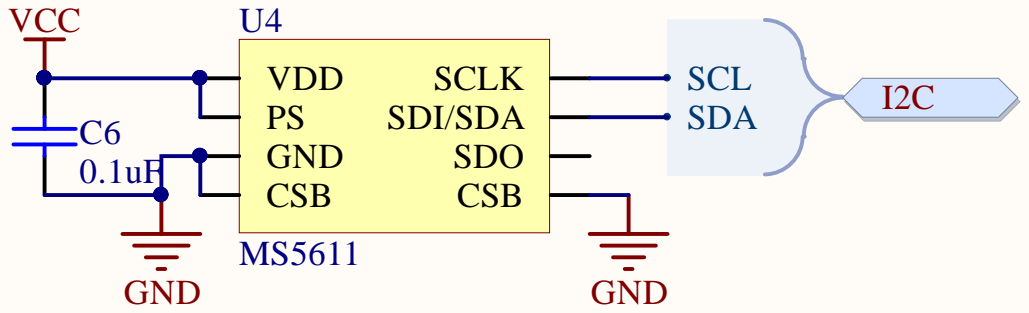
[picture p32: page 9]

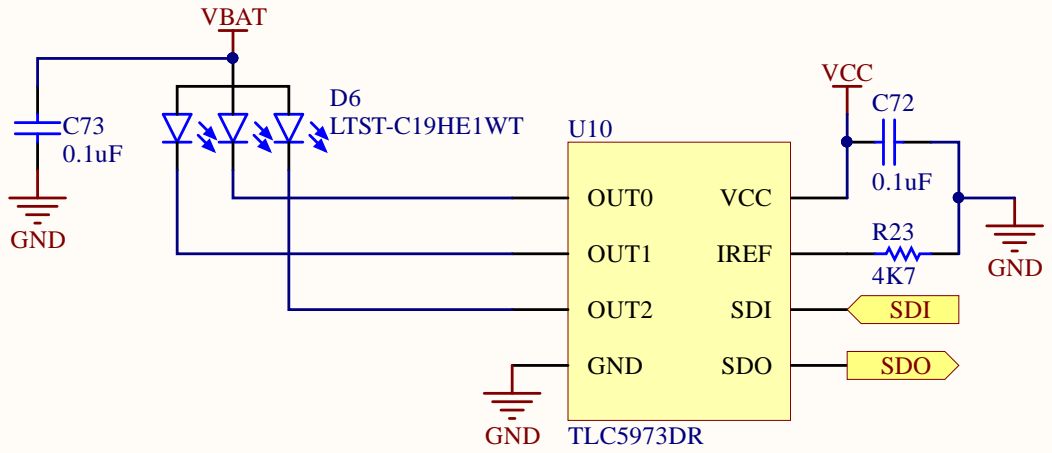
[picture p33: page 10]

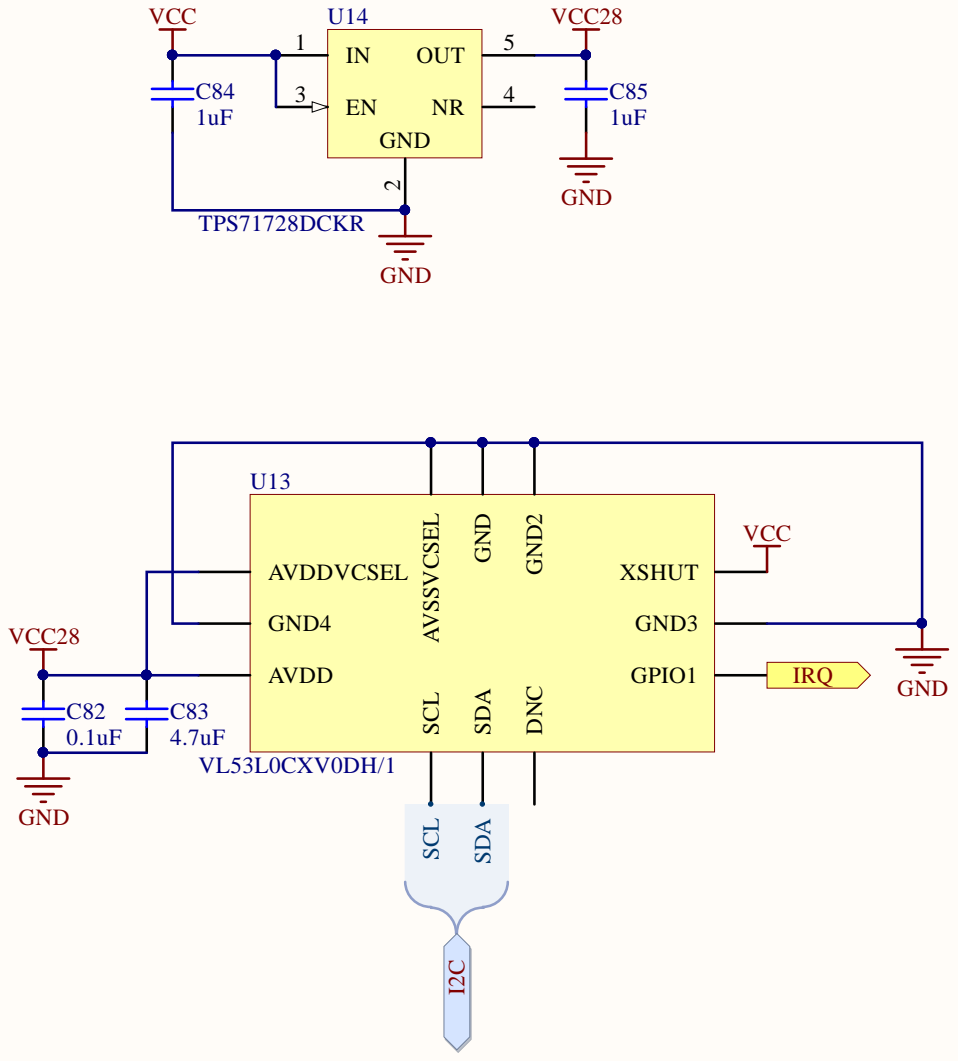
[picture p34: page 11]

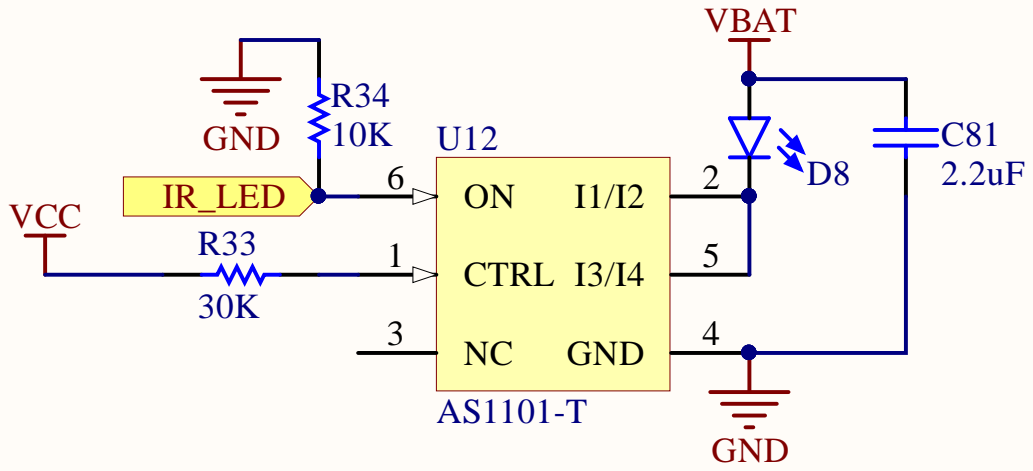
[picture p35: page 12]

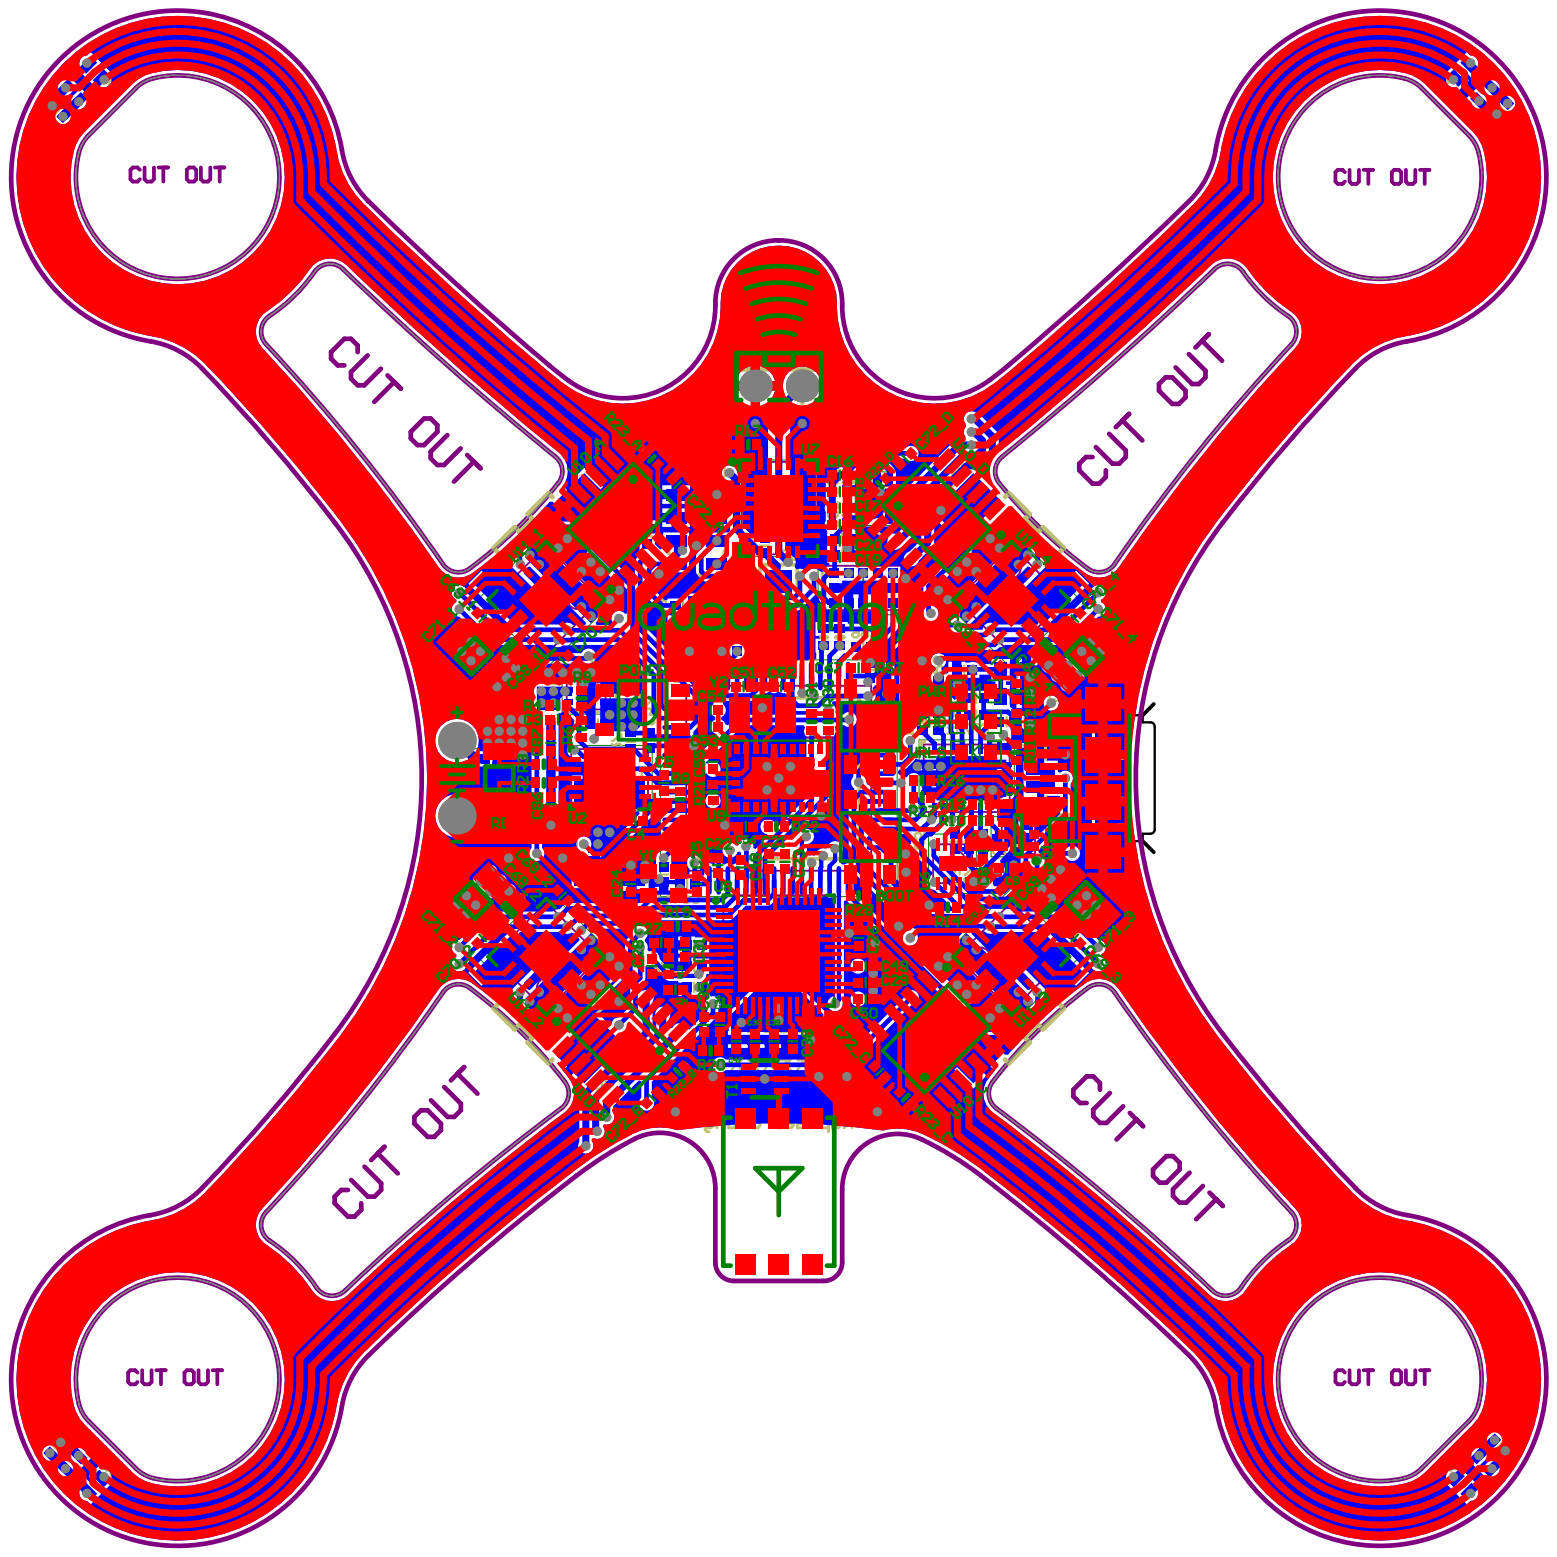
[picture p36: page 13]

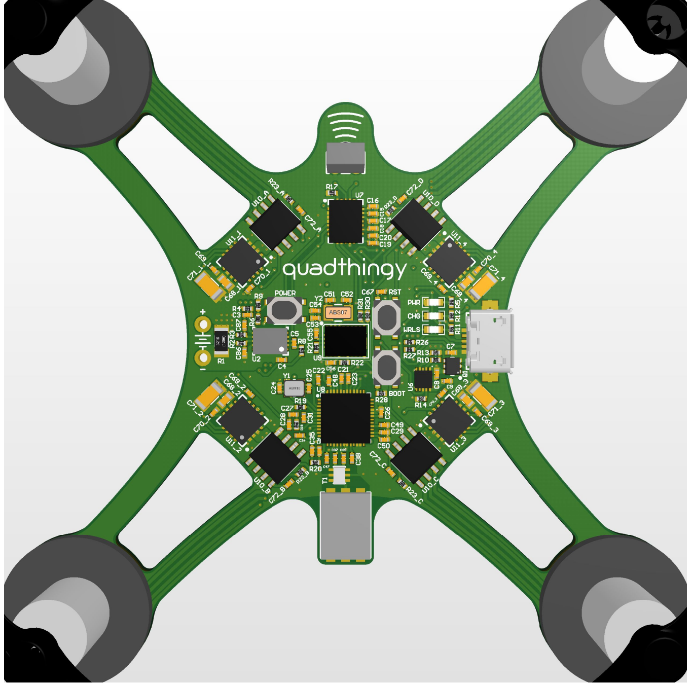
[picture p37: page 14]

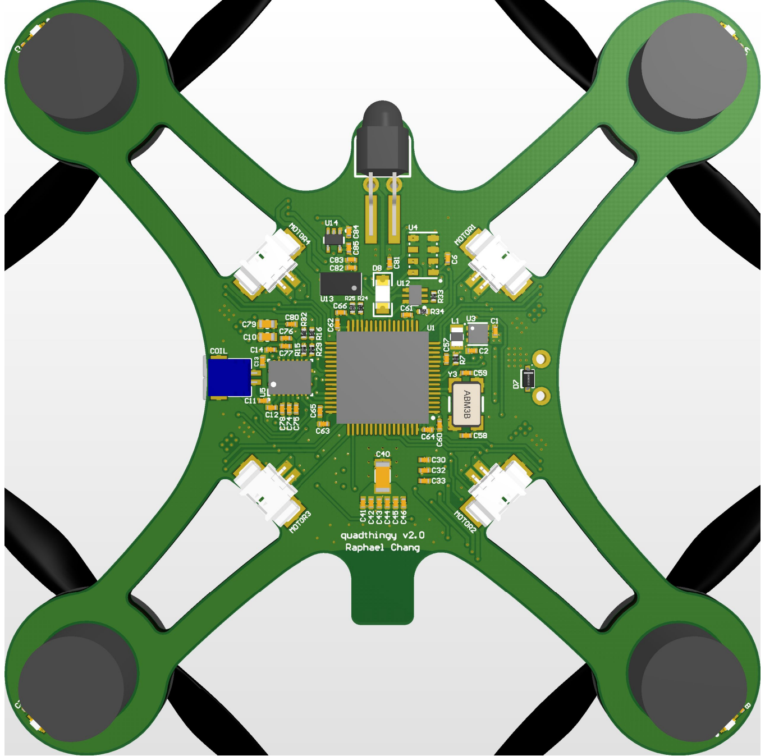
[picture p38: page 15]
