raphaelchang/quadthingy-hardware/(list of files, drawings)

Other design files:
pcb/BaseStation/Barometer.SchDoc
pcb/BaseStation/BaseStation.PcbDoc
pcb/BaseStation/BaseStation.PrjPcb
pcb/BaseStation/BaseStation.SchDoc
pcb/BaseStation/Bluetooth.SchDoc
pcb/BaseStation/Components.SchLib
pcb/BaseStation/DW1000.SchDoc
pcb/BaseStation/Footprints.PcbLib
pcb/BaseStation/IR.SchDoc
pcb/BaseStation/LEDs.SchDoc
pcb/BaseStation/Magnetometer.SchDoc
pcb/BaseStation/MCU.SchDoc
pcb/BaseStation/Power.SchDoc
pcb/BaseStation/WirelessPower.SchDoc
pcb/BrushedESC/BrushedESC.PcbDoc
pcb/BrushedESC/BrushedESC.PrjPcb
pcb/BrushedESC/BrushedESC.SchDoc
pcb/BrushedESC/Components.PcbLib
pcb/BrushedESC/Components.SchLib
pcb/OldVersions/V1.1/Quadrotor/Components.SchLib
pcb/OldVersions/V1.1/Quadrotor/Footprints.PcbLib
pcb/OldVersions/V1.1/Quadrotor/IMU.SchDoc
pcb/OldVersions/V1.1/Quadrotor/Logic.SchDoc
pcb/OldVersions/V1.1/Quadrotor/Power.SchDoc
pcb/OldVersions/V1.1/Quadrotor/Quadrotor.PcbDoc
pcb/OldVersions/V1.1/Quadrotor/Quadrotor.PrjPcb
pcb/OldVersions/V1.1/Quadrotor/Quadrotor.SchDoc
pcb/OldVersions/V1/BrushedESC/BrushedESC.PcbDoc
pcb/OldVersions/V1/BrushedESC/BrushedESC.PrjPcb
pcb/OldVersions/V1/BrushedESC/BrushedESC.SchDoc
pcb/OldVersions/V1/BrushedESC/Components.PcbLib
pcb/OldVersions/V1/BrushedESC/Components.SchLib
pcb/OldVersions/V1/Quadrotor/Components.SchLib
pcb/OldVersions/V1/Quadrotor/Footprints.PcbLib
pcb/OldVersions/V1/Quadrotor/Logic.SchDoc
pcb/OldVersions/V1/Quadrotor/Power.SchDoc
pcb/OldVersions/V1/Quadrotor/Quadrotor.PcbDoc
pcb/OldVersions/V1/Quadrotor/Quadrotor.PrjPcb
pcb/OldVersions/V1/Quadrotor/Quadrotor.SchDoc
pcb/Quadrotor/3V3.SchDoc
pcb/Quadrotor/Barometer.SchDoc
pcb/Quadrotor/Charging.SchDoc
pcb/Quadrotor/Components.SchLib
pcb/Quadrotor/DistanceSensorBottom.SchDoc
pcb/Quadrotor/DistanceSensorFront.SchDoc
pcb/Quadrotor/DW1000.SchDoc
pcb/Quadrotor/Footprints.PcbLib
pcb/Quadrotor/IMU.SchDoc
pcb/Quadrotor/IR.SchDoc
pcb/Quadrotor/LED.SchDoc
pcb/Quadrotor/LEDs.SchDoc
pcb/Quadrotor/Logic.SchDoc
pcb/Quadrotor/MCU.SchDoc
pcb/Quadrotor/MotorDriver.SchDoc
pcb/Quadrotor/Power.SchDoc
pcb/Quadrotor/Quadrotor.PcbDoc
pcb/Quadrotor/Quadrotor.PrjPcb
pcb/Quadrotor/Quadrotor.SchDoc
