raphaelchang/quadthingy-hardware/(commit log)

2016-02-01 Initial design
    [Components.SchLib, Footprints.PcbLib, Logic.SchDoc, Power.SchDoc, Quadrotor.PcbDoc, Quadrotor.PrjPcb, Quadrotor.SchDoc, outline.0006.ipt]
2016-03-18 Started code, imported ChibiOS, setup peripherals
    [stm_spc56ec74a256s_spc56ec74_minimodule_debug_jtag.cfg, stm_xpc560b64_minimodule_debug_jtag.cfg, stm_xpc560b_spc560d40_minimodule_debug_jtag.cfg, stm_xpc560p_minimodule_40mhz_debug_jtag.cfg, stm_xpc563m64_minimodule_debug_jtag.cfg, stm_xpc564a_spc564a70_minimodule_debug_jtag.cfg, stm_xpc56el_minimodule_lockstep_debug_jtag.cfg]
2016-03-20 IMU works
2016-03-29 compiler switched to cpp 11, message subscriber works
2016-03-31 remove debug print
2016-05-14 Flies wirelessly!
    [BrushedESC.GBL, BrushedESC.GBO, BrushedESC.GBP, BrushedESC.GBS, BrushedESC.GKO, BrushedESC.GTL, BrushedESC.GTO, BrushedESC.GTP]
2016-12-16 Finished v2 quadthingy
    [3V3.SchDoc, Barometer.SchDoc, BaseStation.PrjPcb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]
2016-12-26 thingystation v1
    [Barometer.SchDoc, BaseStation.PcbDoc, BaseStation.PrjPcb, BaseStation.SchDoc, Bluetooth.SchDoc, Charging.SchDoc, Components.SchLib, DW1000.SchDoc]
2016-12-30 Finalized for manufacturing
    [Barometer.SchDoc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]
2017-01-09 Move code to other repo
    [BaseStation.PrjPcb, stm_spc56ec74a256s_spc56ec74_minimodule_debug_jtag.cfg, stm_xpc560b64_minimodule_debug_jtag.cfg, stm_xpc560b_spc560d40_minimodule_debug_jtag.cfg, stm_xpc560p_minimodule_40mhz_debug_jtag.cfg, stm_xpc563m64_minimodule_debug_jtag.cfg, stm_xpc564a_spc564a70_minimodule_debug_jtag.cfg, stm_xpc56el_minimodule_lockstep_debug_jtag.cfg]
2020-12-25 Old files
    [BaseStation.PcbDoc, BaseStationTop.SLDPRT, Footprints.PcbLib, MotorMount.SLDPRT, MotorMount.STEP, MotorMount_Alt.SLDPRT]
